creeperdeking/Tropodrone/Latex/diapo_rapport.tex

\documentclass{beamer}

\usepackage{gensymb}
\input{entete_beamer_pdflatex}
\usepackage{listings}
\usepackage[babel=true]{csquotes}
\lstset{language=Python, tabsize=2, breaklines=true, showstringspaces=false}

\useoutertheme{infolines}
\setbeamersize{text margin left=1cm,text margin right=1cm}

\title{Rapport de projet de SI}
\subtitle{Tropodrone}
\author{Gueydan Noé, Manceau Thibaut, Gros Alexis, Porteries Tristan}

\begin{document}

\begin{frame}
  \titlepage
\end{frame}

\begin{frame}
    \frametitle{Sommaire}
    \begin{multicols}{2}
      {
		\setcounter{tocdepth}{1}
        \tableofcontents
      }
    \end{multicols}
\end{frame}

\section{Courte présentation}

\subsection{But du projet}
\begin{frame}{But du projet}
 Créer une structure composée de ballons contenant un gaz plus léger que l’air qui soutient une partie ou la totalité du poids d'un drone.
\end{frame}

\subsection{Objectifs}
\begin{frame}{Objectifs}
 Augmenter l’autonomie, la sécurité et les possibilités d’un drone de petite taille
\end{frame}

\subsection{Contraintes imposées au projet}
\begin{frame}{Contraintes imposées au projet}
  \begin{itemize}
    \item être simple d’utilisation, garder la manœuvrabilité du drone au possible, voler le plus longtemps possible~;
    \item consommer le moins d’énergie possible, ne pas présenter de danger pour le public et économiser le gaz et les matériaux de fabrication~;
    \item le modèle du drone imposé~;
    \item rayon d’action de minimum 15 mètres~;
    \item ballon de type dirigeable.
  \end{itemize}
\end{frame}

\subsection{Contraintes légales supplémentaires}
\begin{frame}{Contraintes légales supplémentaires}
  \begin{itemize}
    \item 1~: Le drone \\
	    catégorie A~: limitations non contraignantes~;
    \item 2~: Le ballon \\
	    catégorie « Léger » \\
	    la ficelle supportant la charge doit casser au dessus de 23 kg.
 \end{itemize}
\end{frame}

\section{Calculs d'élévation}

\subsection{Poussé d'archimède}

\begin{frame}{Définition}
  \enquote{Tout corps plongé dans un fluide au repos, entièrement mouillé par celui-ci ou traversant sa surface libre, subit une force verticale, dirigée de bas en haut et opposée au poids du volume de fluide déplacé ; cette force est appelée poussée d'Archimède.}
  \bigbreak
  \begin{center}
    \boxed{\vv{Pa} = -M_F \times \vv{g}}
  \end{center}
  \begin{itemize}
    \item $\vv{Pa}$~: la poussé d'archimède~;
    \item $M_F$~: la masse du fluide contenue dans le volume déplacé~;
    \item $\vv{g}$~: la valeur du champ de pesanteur.
  \end{itemize}
\end{frame}

\begin{frame}{Application aux gaz}
  Deux forces appliquées sur le ballon~: \\
  \begin{center}
    $\displaystyle{\vv{F_{ballon}} = \vv{P_{ballon}} + \vv{Pa_{ballon}}}$ \\
  \end{center}
  Si $P_{ballon} < Pa_{ballon}$ la force d'élévation est~:
  \begin{center}
    $\displaystyle{F_{ballon} = Pa_{ballon} - P_{ballon}}$ \\
  \end{center}
  Remarque~:\\
  \begin{center}
    $F_{ballon} < Pa_{ballon}$
  \end{center}
\end{frame}

\begin{frame}{Hydrogène et hélium}
	\begin{center}
		\begin{tabular}{|l|c|c|c|}
			\hline
			Gaz & Air & Hydrogène & Hélium \\
			\hline
			Masse Volumique $(kg.m^3)$ & 1.29 & 0.08988 & 0.1785 \\ 
			\hline
			Force d'élévation $(N.m^3)$ & 0 & 10.90 & 11.77 \\
			\hline
		\end{tabular}
	\end{center}
\end{frame}

\subsection{Dilatation des gaz}

\begin{frame}{Loi de Charles}
  \begin{center}
    \boxed{\displaystyle{\frac{V_1}{T_1} = \frac{V_2}{T_2} = f(P, n)}} \\
    $\displaystyle{V_3 = f(P, n) \times T_3}$
  \end{center}
  Avec~:
  \begin{itemize}
    \item $V_q$~: volume du gaz en $m^3$ à la température $T_q$ en K~;
    \item $P$~: pression du gaz en Pa~;
    \item $n$~: quantité de matière en mol~;
    \item $f(P, n)$~: rapport constant entre volume et température.
  \end{itemize}
\end{frame}

\begin{frame}{Application à l'hélium}
  Volume molaire de l'hélium~: $22.414\times 10^{-3} m^3.mol^{-1}$ à $273.25K$.
  \begin{center}
    $\displaystyle{f(P, n) = \frac{22.414\times 10^{-3}}{273.25} = 8.2\times 10^{-5} m^3.mol^{-1}.K^{-1}}$
  \end{center}
  Pour $T_{200} = 200 \degree C = 473.25 K$~:
  \begin{center}
    $\displaystyle{V_{T_{200}} = 8.2\times 10^{-5} * 473.25 = 38.811 \times 10^{-3}} m^3.mol^{-1}$
  \end{center}
  Augmentation du volume de $1.59$.
\end{frame}

\begin{frame}{Résultat de la poussé d'archimède}
  \begin{center}
    $\displaystyle{F_{T_0} = Pa_{air} - P_{helium} = 10.90 N}$
    \bigbreak
    $\displaystyle{F_{T_{200}} = Pa_{air} - \frac{P_{helium}}{1.59} = 11.57 N}$ \\
  \end{center}
  Les resultats sont négligables. $F < Pa_{air}$
\end{frame}

\section{Structure}

\subsection{Piloter le drone}

\begin{frame}
  La structure~: piloter le drone.
  Les contraintes~:
  \begin{itemize}
    \item mobilité~;
    \item rigidité~;
    \item légerté~;
    \item légalité.
  \end{itemize}
\end{frame}

\begin{frame}{Les solutions techniques}
  Légerté et rigidité~: fibres de carbonne Répartition des matériaux et expériences.
  \begin{center}
    
  \end{center}
\end{frame}

\begin{frame}{Mobilité}
  Forme triangulaire des ballons, centre de gravité, le même que celui du drone, quantité d'hélium. \\
  Structure gyroscopique.
  \begin{center}
    
  \end{center}
\end{frame}

\subsection{Attaches et modélisation}

\begin{frame}
  \begin{center}
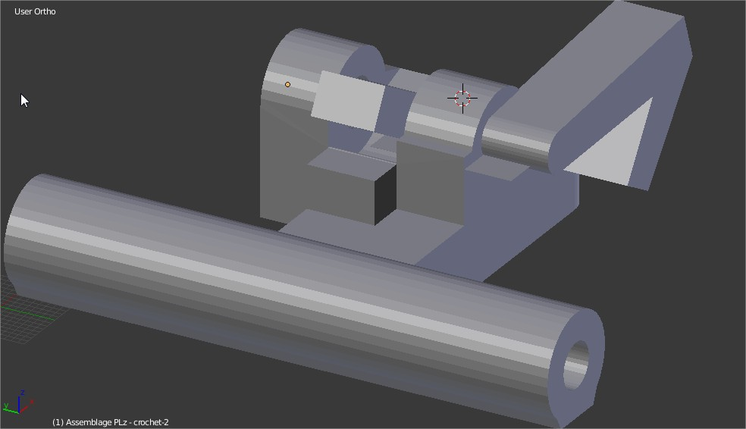
[picture p17: Images/fixation.jpg]
    
  \end{center}
  \captionof{figure}{Fixation triangle-premier cercle.}
\end{frame}

\section{Ballon}

\subsection{Contenance}

\begin{frame}
  Volume d'helium nécessaire~: $0.75 m^3$
  
  Volume des ballons~: $0.25 m^3$
\end{frame}

\subsection{Forme}

\begin{frame}
  Les ballon sont formés d'un parallèlépipède de longueur 1m avec deux pyramides d'angle $60\degree$. Orientation de $45\degree$ \\
  \begin{center}
    
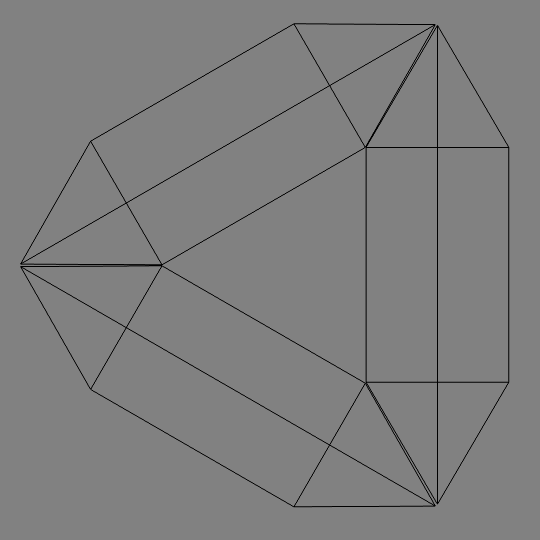
[picture p18: Images/ballon3.png]
    
  \end{center}
\end{frame}

\begin{frame}{Calcul des dimensions}
  Volume ballon~:
  \begin{center}
    \boxed{\displaystyle{V = 2(\sqrt{2b^2} \times \tan \frac{\pi}{3} \times \frac{1}{3} \times b^2) + b^2}} \\
    $\displaystyle{V = 2(\frac{\sqrt{6}}{3} \times b^3) + b^2 }$ \\
    $\displaystyle{b^3 \frac{2\sqrt{6}}{3} + b^2 - 0.25 = 0}$
  \end{center}
  Où $b$ est la largeur du parallèlépipède. \\
  Polynome du troisième degrée, résolution par bissection ou dichotomie.
\end{frame}

\begin{frame}[fragile]{Résolution par bissection}
  \begin{lstlisting}[frame=single]
etape = 1
largeur = 1
vol = volume(largeur)
cible = 0.25
epsilon = 1e-4
while abs(vol - cible) > epsilon:
	if vol < cible:
		largeur += etape
	else:
		largeur -= etape
	etape /= 2
	vol = volume(largeur)

print("volume = %f, diametre = %f" % (vol, largeur))
  \end{lstlisting}
\end{frame}

\subsection{Patron du ballon}

\begin{frame}
  \begin{center}
    
  \end{center}
\end{frame}

\subsection{Enveloppe}

\begin{frame}
  \begin{multicols}{2}
    \begin{itemize}
      \item Latex~:
      \begin{itemize}
        \item facile à trouver dans le commerce,
        \item seulement en forme sphèrique,
        \item peu étanche~;
      \end{itemize}
      \item Chloroprène~:
      \begin{itemize}
        \item introuvable dans le commerce~;
      \end{itemize}
      \item Butyle~:
      \begin{itemize}
        \item introuvable dans le commerce~;
      \end{itemize}
      \item Hypalon~:
      \begin{itemize}
        \item introuvable dans le commerce,
        \item fragile aux ultraviolets.
      \end{itemize}
    \end{itemize}
    \newpage
    \begin{itemize}
      \item Mylar (polyéthylène téréphtalate, PET)~:
      \begin{itemize}
        \item facile à trouver dans le commerce,
        \item resistant à la traction,
        \item peu être assembler,
        \item raide,
        \item fragile au cisaillement et à la perforation.
      \end{itemize}
    \end{itemize}
  \end{multicols}
\end{frame}

\subsection{Collage}

\begin{frame}
  \begin{multicols}{2}
    \begin{itemize}
      \item Néoprène(Polychloroprène)
      \begin{itemize}
        \item étanche,
        \item élastique,
        \item adhèrent,
        \item difficile à appliquer~;
      \end{itemize}
      \item 406 (cyanoacrylate d'ethyle) et 770 (primaire)
      \begin{itemize}
        \item adhèrent,
        \item rigide,
        \item peu résistant à l'eau,
        \item facile à appliquer~;
      \end{itemize}
      \item 401 (cyanoacrylate) et 770 (primaire)
      \begin{itemize}
        \item adhèrent,
        \item rigide,
        \item peu résistant à l'eau,
        \item facile à appliquer.
      \end{itemize}
    \end{itemize}

    \newpage

    \begin{itemize}
      \item 330 et activateur
      \begin{itemize}
        \item peu adhèrent,
        \item élastique~;
      \end{itemize}
      \item Polyester
      \begin{itemize}
        \item peu adhèrent~;
      \end{itemize}
      \item Polyuréthane
      \begin{itemize}
        \item peu adhèrent~;
      \end{itemize}
      \item Acétone
      \begin{itemize}
        \item peu adhèrent~;
      \end{itemize}
      \item Vinylique
      \begin{itemize}
        \item peu adhèrent.
      \end{itemize}
    \end{itemize}
    %\begin{center}
    %  \includegraphics[width=5cm]{../Images/colle2.jpg}
    %\end{center}
    %\captionof{figure}{A gauche la colle 406 et à droite la colle acétone.}
  \end{multicols}
\end{frame}

\subsection{Performance d'un collage}

\begin{frame}{Contrainte d'une colle}
  Différents types de contraintes sur une colle:
  \begin{center}
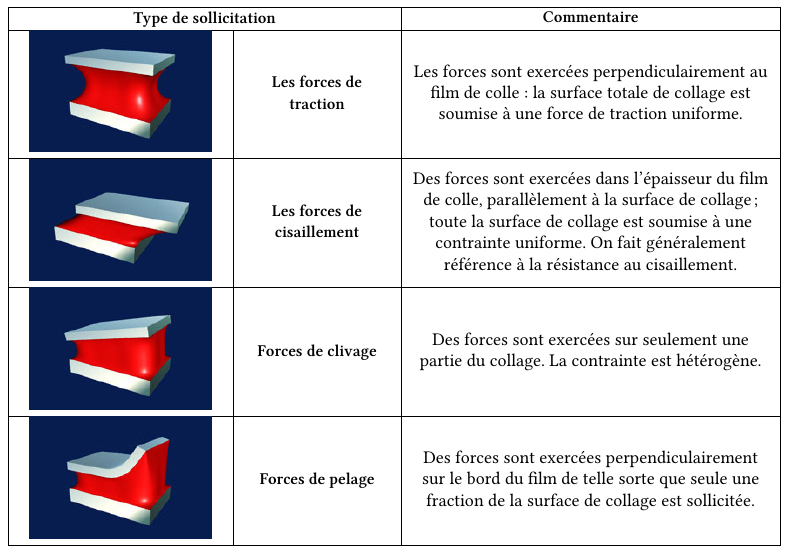
[picture p19: Images/colle_contraintes.png]
    
  \end{center}
\end{frame}

\begin{frame}
  Collage du ballon extérieur: contrainte de pellage.
  \begin{center}
    
    
  \end{center}
\end{frame}

\begin{frame}{Tests 401 (cyanoacrylate)}
  \begin{center}
    \begin{tabular}{|c|c|}
      \hline
      Pelage & Cisaillement \\
      \hline
      $0.45 N.cm^{-2}$ & $12.1 N.cm^{-2}$ \\
      \hline
    \end{tabular}
  \end{center}
  \begin{center}
    
    
  \end{center}
\end{frame}

\section{Drone}

\subsection{Modèle}

\begin{frame}
  \begin{multicols}{2}
    Drone XCSOURCE~: \\
    \begin{itemize}
      \item 290 mm diagonale~;
      \item 190 mm longueur~;
      \item 70 mm hauteur~;
      \item moteur EMAX MT2204 2300KV Brushless Motor~;
      \item Accu Lipo Gens Ace 2200Mah 11.1V 25C 3S~;
      \item 450 g.
    \end{itemize}
    \newpage
    \begin{center}
      
    \end{center}
    \captionof{figure}{Drone XCSOURCE.}
  \end{multicols}
\end{frame}

\subsection{Capacité et poids}

\section{Aérodynamisme}

\subsection{Équation de traînée}
\begin{frame}{Équation de traînée}
 But : que le drone soit le moins sensible à l'air possible \\
 Force de traînée matérialisée par l'équation \\
 \begin{center}
  \boxed{\displaystyle{\frac12 \times \rho \times S \times Cx \times V^2}}
 \end{center}
 Avec~:
 \begin{itemize}
  \item $\rho$ la masse volumique du fluide dans lequel a lieu le déplacement en $kg.m^{-3}$~;
  \item S la surface~;
  \item Cx le coefficient de traînée~;
  \item V la vitesse relative du mobile par rapport au fluide en $m.s^{-1}$.
 \end{itemize} 
\end{frame}

\subsection{Calcul de Cx}
\begin{frame}{Nombre de Reynolds}
 \begin{center}
  \boxed{\displaystyle{Re = \frac{VL}{\nu}}}
 \end{center}
 Avec~: \\
 \begin{itemize}
  \item V vitesse du fluide en $m.s^{-1}$~;
  \item L diamètre en m~;
  \item $\nu$ Viscosité cinématique en $m^2.s^{-1}$ ($\nu = 15.6 \times 10^6$ pour l'air).
 \end{itemize} 
\end{frame}

\begin{frame}{Calcul de Cx pour la forme retenue}
 Forme la plus proche : sphère \\
 Dépend du type d'écoulement : le nombre de reynolds \\
 \begin{center}
  $\begin{array}{>{\displaystyle}l>{\displaystyle}l>{\displaystyle}l}
   Re < 1 & Cx = & \frac{24}{Re} \medbreak \\
   1 < Re < 10^3 & Cx = & \frac{18.5}{Re^{0.6}} \medbreak \\
   10^3 < Re < 5.10^5 & Cx = & 0.44
  \end{array}$
 \end{center}
\end{frame}

\section{Taches à faire}
\begin{frame}
  \begin{itemize}
    \item terminer les pièces du ballon~;
    \item assembler la structure~;
    \item assembler les ballons~;
    \item tester et calculer l'aérodynamisme~;
    \item calibrer le drone~;
    \item acheter l'helium.
  \end{itemize}
\end{frame}

\end{document}
