creeperdeking/Tropodrone/Latex/diapo_general.tex

\documentclass{beamer}

\usepackage{gensymb}
\input{entete_beamer_pdflatex}
\usepackage{listings}
\usepackage{transparent}
\usepackage[babel=true]{csquotes}
\lstset{language=Python, tabsize=2, breaklines=true, showstringspaces=false}

\definecolor{RedT}{rgb}{1, .7, .7}
\definecolor{GreenT}{rgb}{.7, 1, .7}
\definecolor{OrangeT}{rgb}{1, 1, .7}

\useoutertheme{infolines}
\setbeamersize{text margin left=1cm,text margin right=1cm}

\title{Rapport de projet de SI}
\subtitle{Tropodrone}
\author{Gueydan Noé, Manceau Thibaut, Gros Alexis, Porteries Tristan}

\usebackgroundtemplate%
{%
    {\transparent{0.2}}%
}

\begin{document}

\begin{frame}
  \titlepage
\end{frame}

\begin{frame}
    \frametitle{Sommaire}
    \begin{multicols}{2}
      {
		\setcounter{tocdepth}{1}
        \tableofcontents
      }
    \end{multicols}
\end{frame}
