creeperdeking/Tropodrone/Images/ballon2.jpg

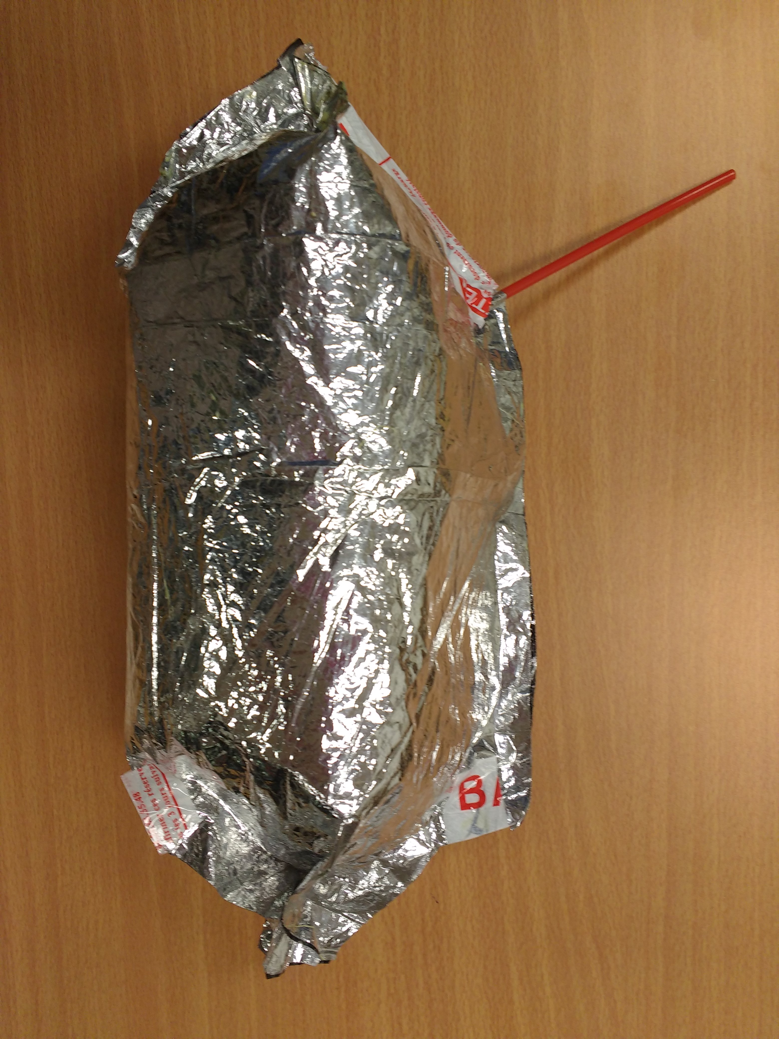
Images/ballon2.jpg
