creeperdeking/Tropodrone/Images/ballon3.jpg

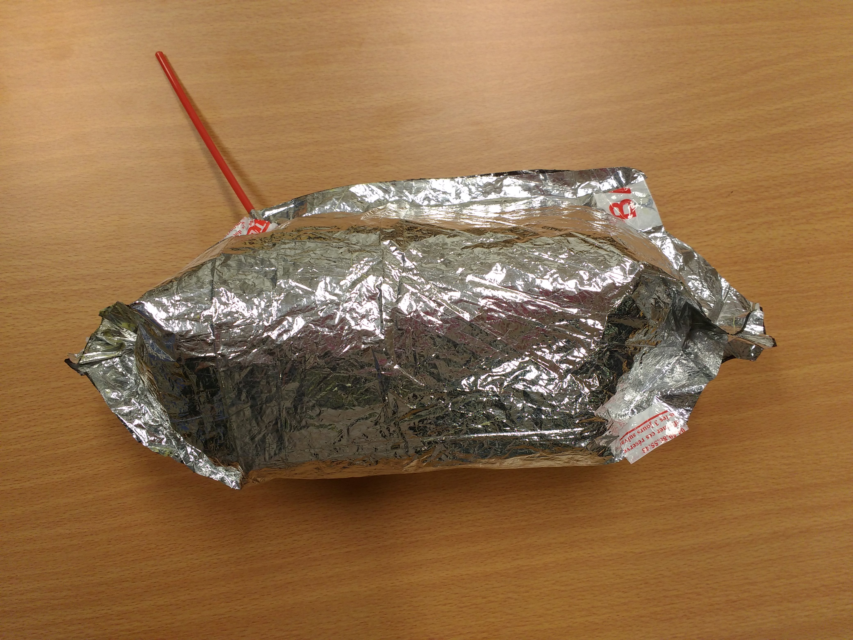
Images/ballon3.jpg
