creeperdeking/Tropodrone/Images/colle.JPG

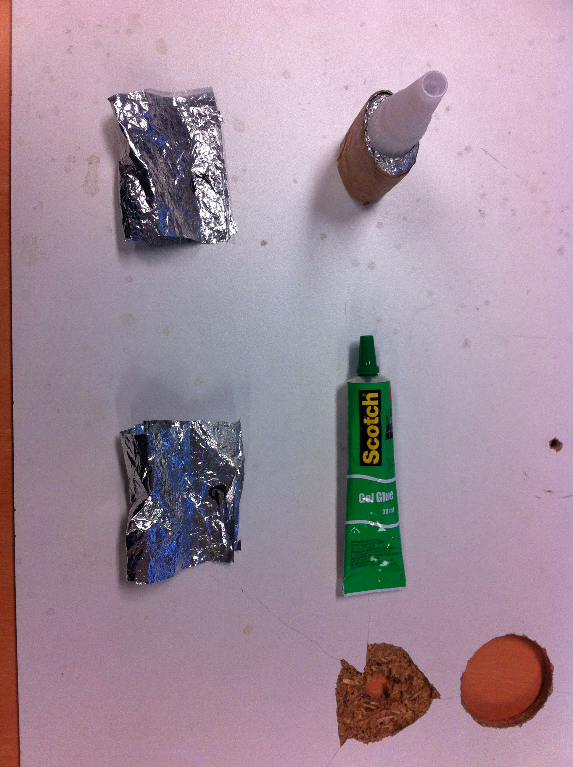
Images/colle.JPG
