creeperdeking/Tropodrone/Images/colle_cyano.JPG

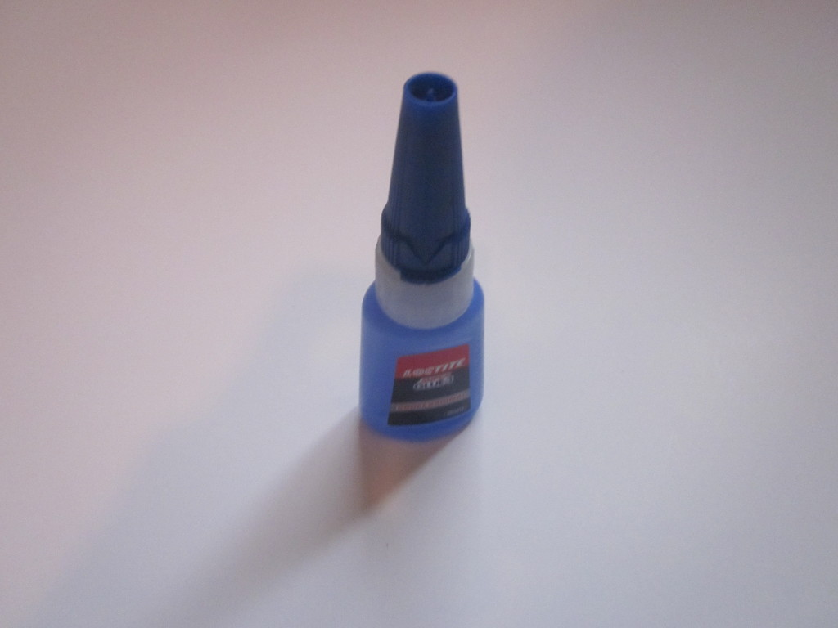
Images/colle_cyano.JPG
