creeperdeking/Tropodrone/Images/IMG_20170321_155133.jpg

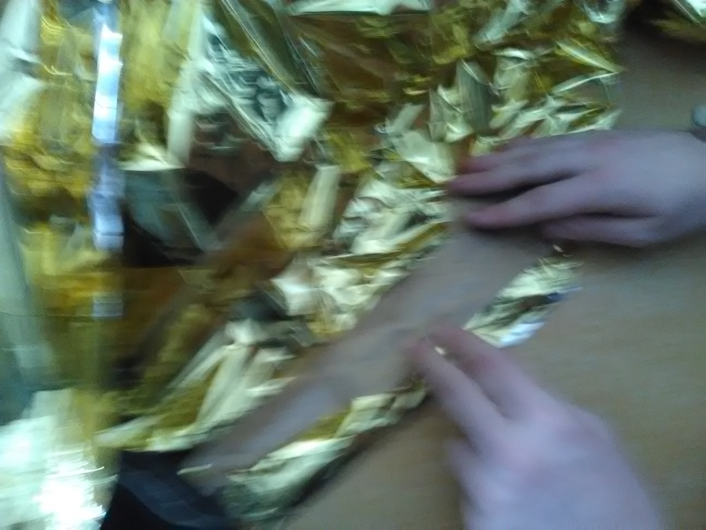
Images/IMG_20170321_155133.jpg
