creeperdeking/Tropodrone/Images/IMG_20170321_155136.jpg

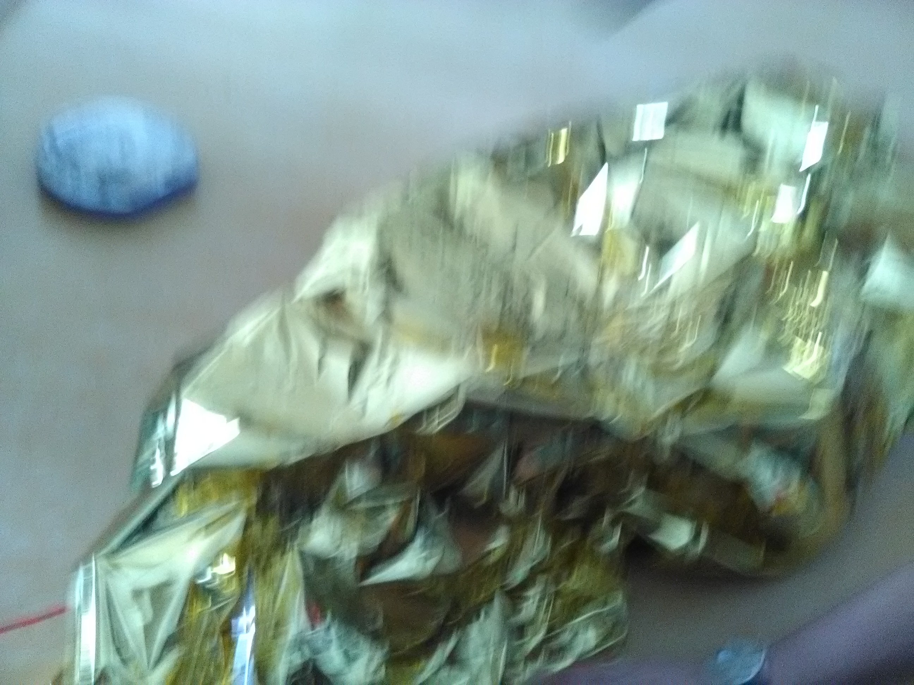
Images/IMG_20170321_155136.jpg
