creeperdeking/Tropodrone/Images/IMG_20170321_155141.jpg

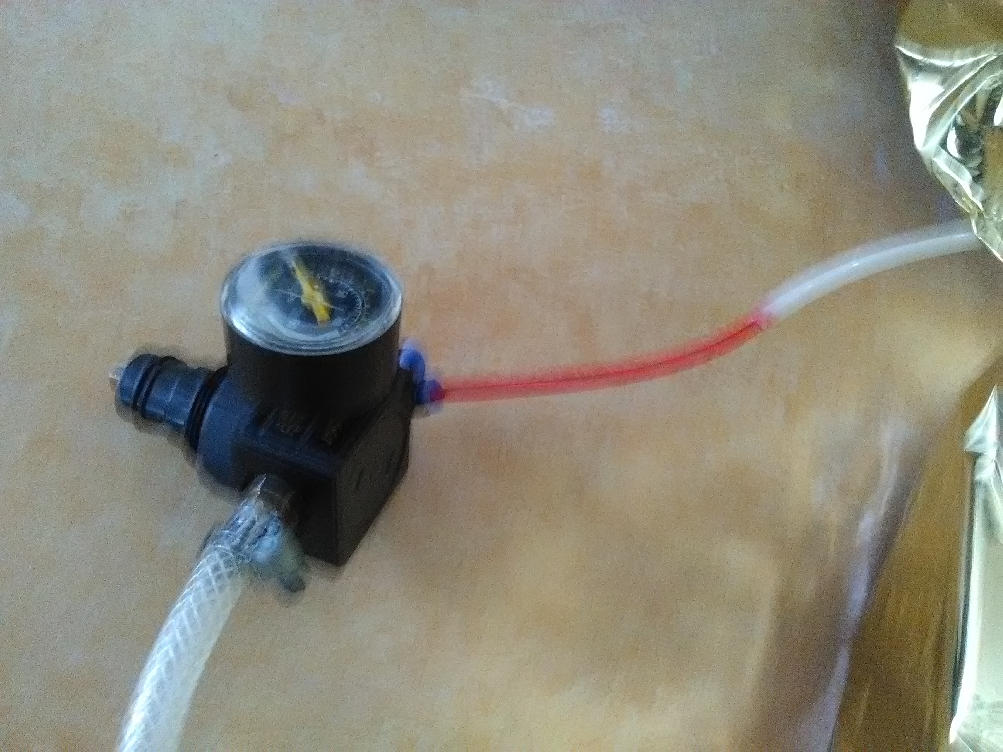
Images/IMG_20170321_155141.jpg
