creeperdeking/Tropodrone/Images/IMG_20170321_155143.jpg

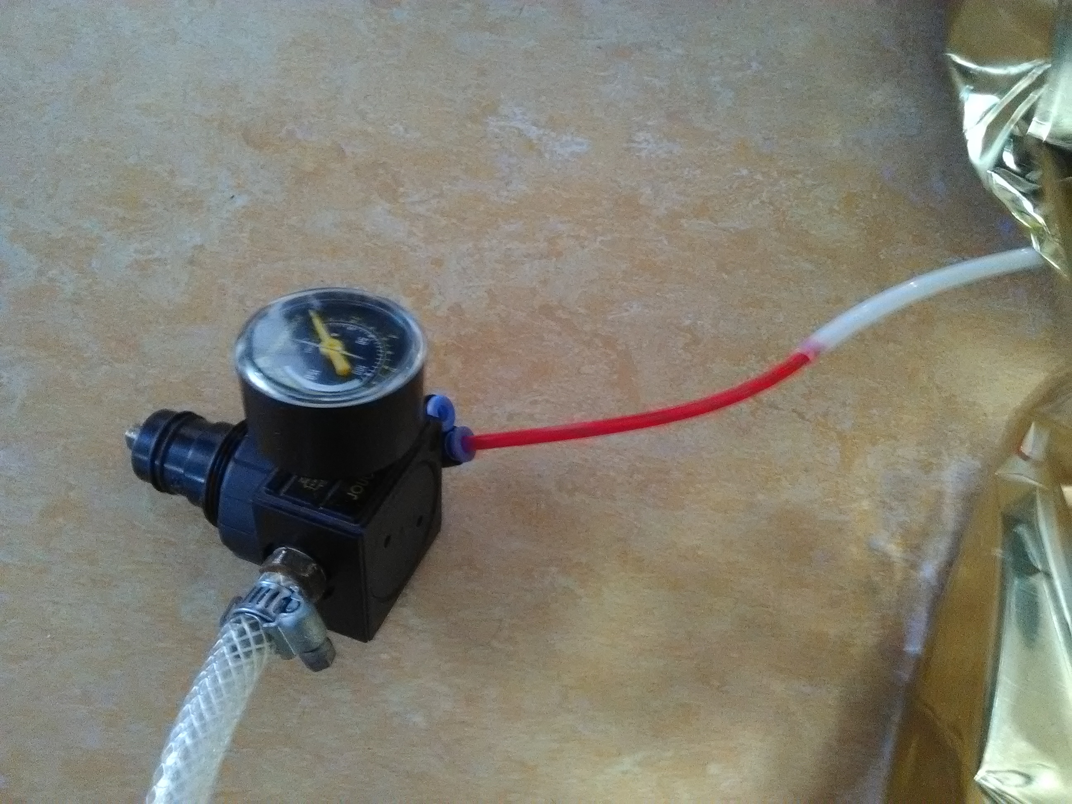
Images/IMG_20170321_155143.jpg
