creeperdeking/Tropodrone/Images/IMG_20170321_160333.jpg

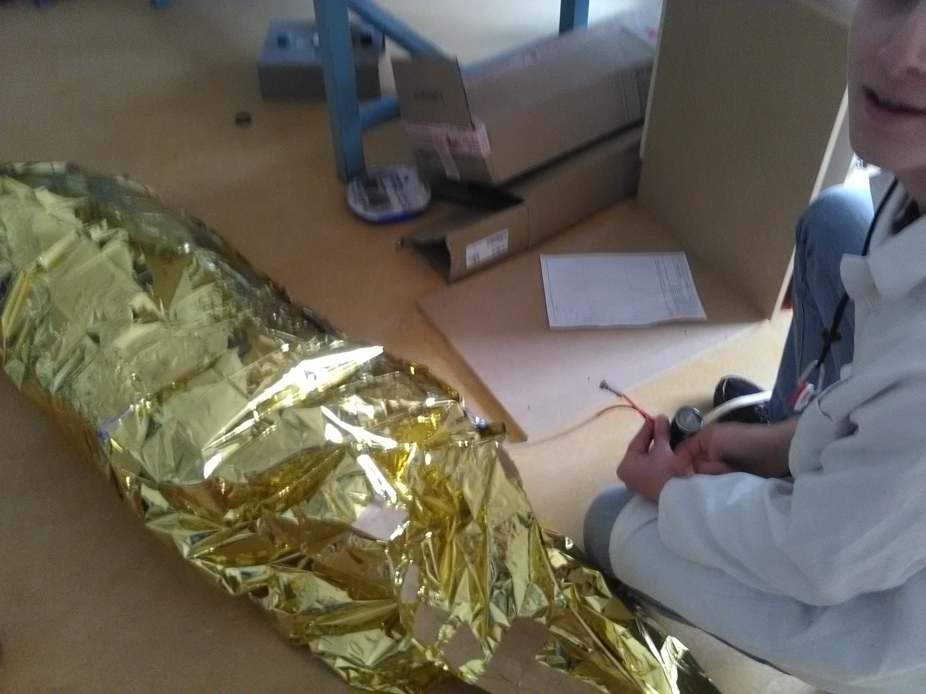
Images/IMG_20170321_160333.jpg
