creeperdeking/Tropodrone/Images/IMG_20170321_160751.jpg

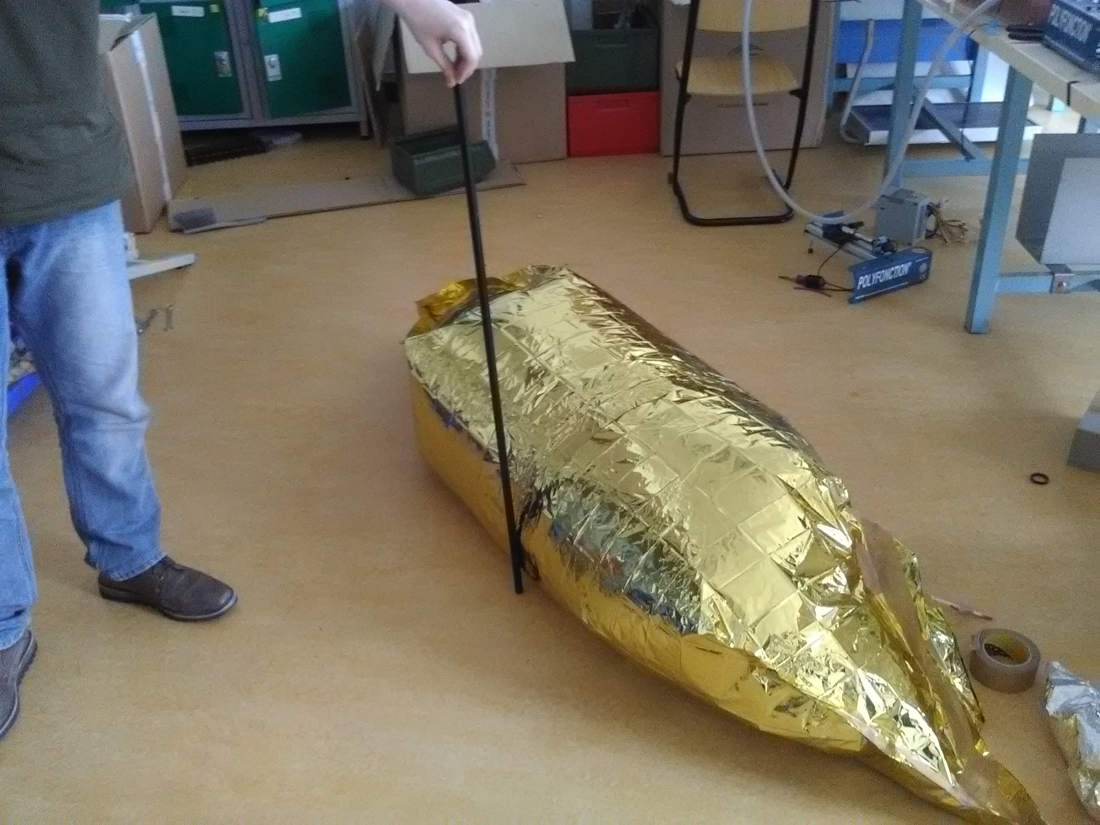
Images/IMG_20170321_160751.jpg
