creeperdeking/Tropodrone/Images/IMG_20170321_162557.jpg

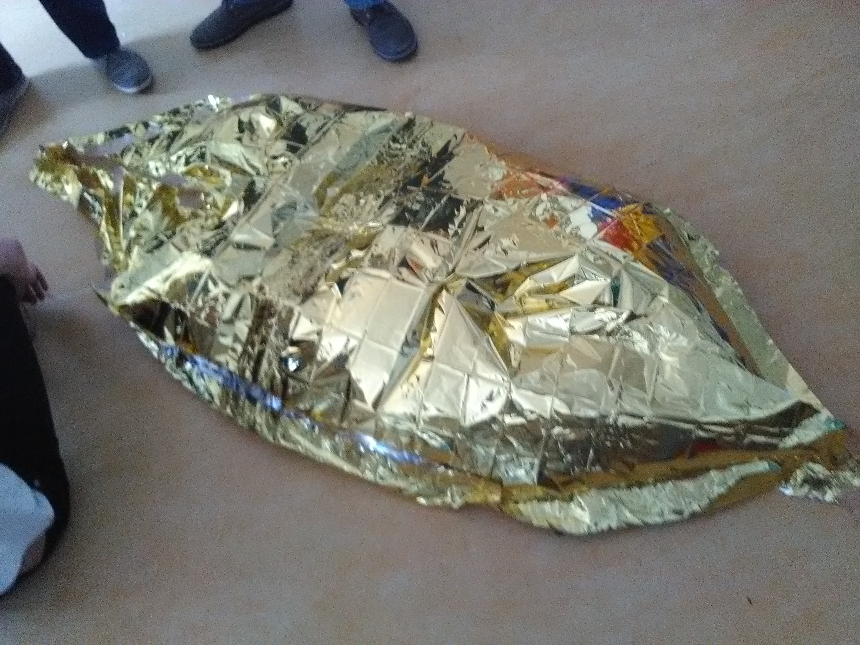
Images/IMG_20170321_162557.jpg
