creeperdeking/Tropodrone/Images/IMG_20170321_162559.jpg

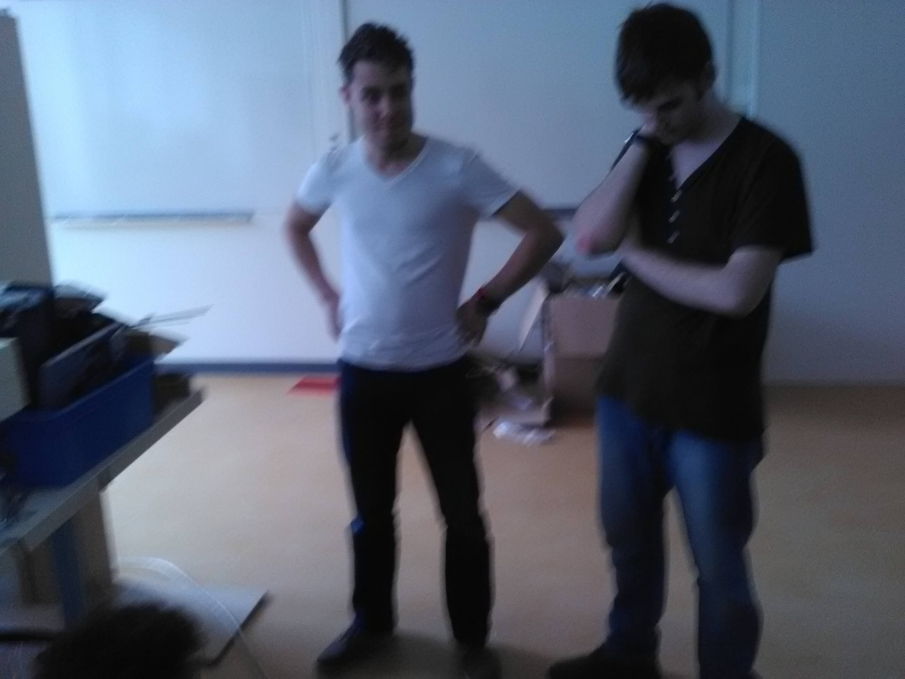
Images/IMG_20170321_162559.jpg
