creeperdeking/Tropodrone/Images/IMG_20170321_162600.jpg

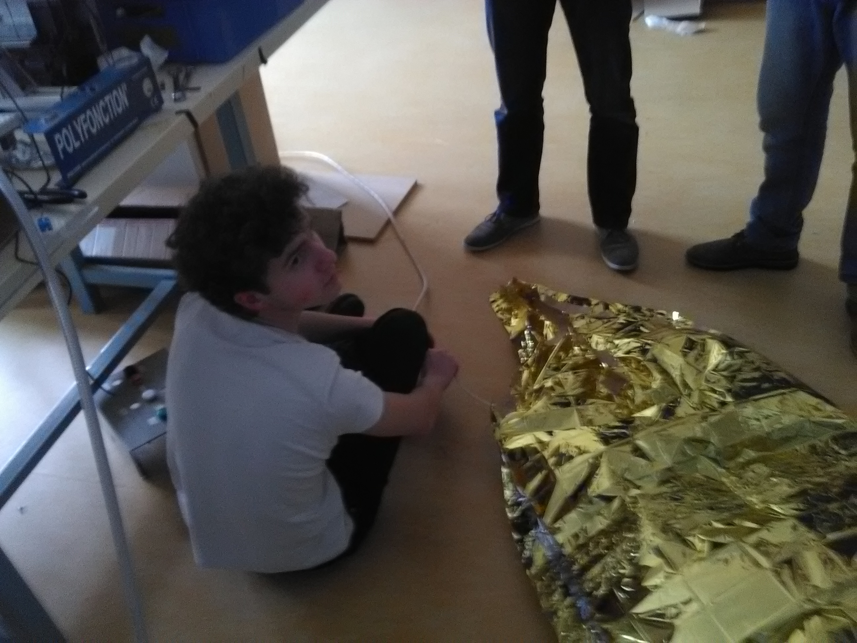
Images/IMG_20170321_162600.jpg
