creeperdeking/Tropodrone/Images/Photos/IMG_20161213_135336.jpg

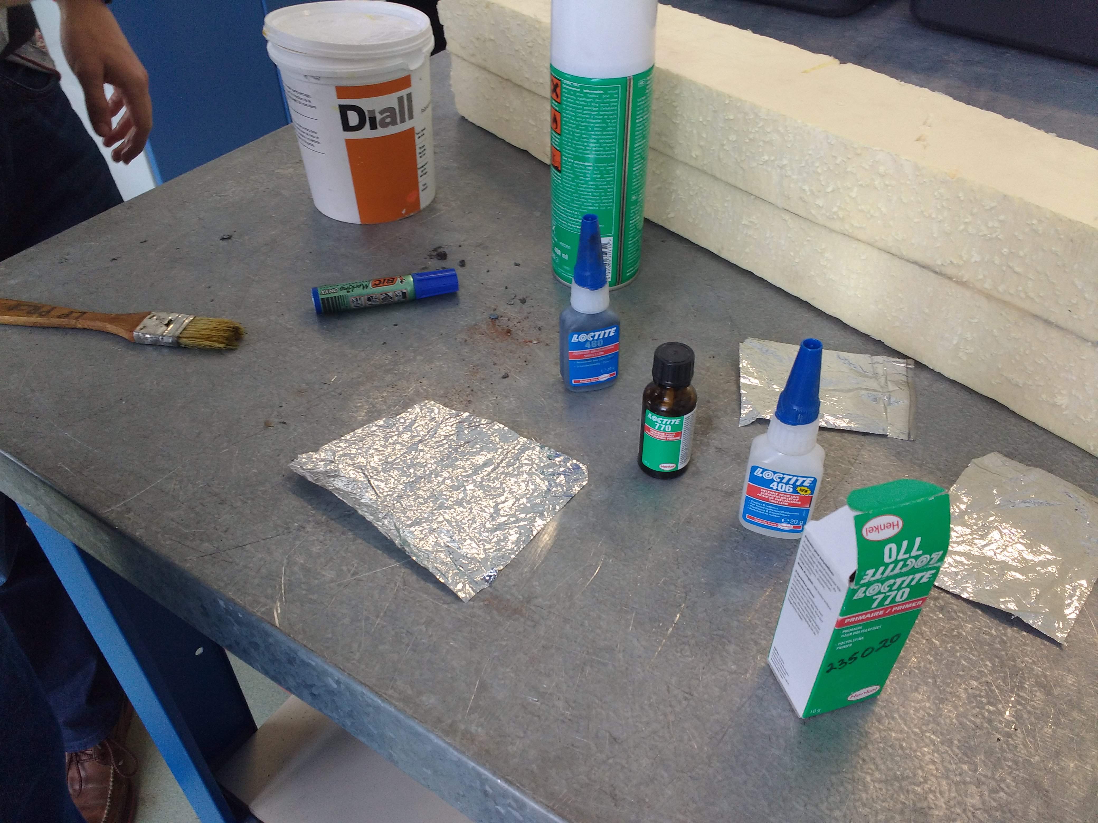
Images/Photos/IMG_20161213_135336.jpg
