creeperdeking/Tropodrone/Images/Photos/IMG_20161213_160055.jpg

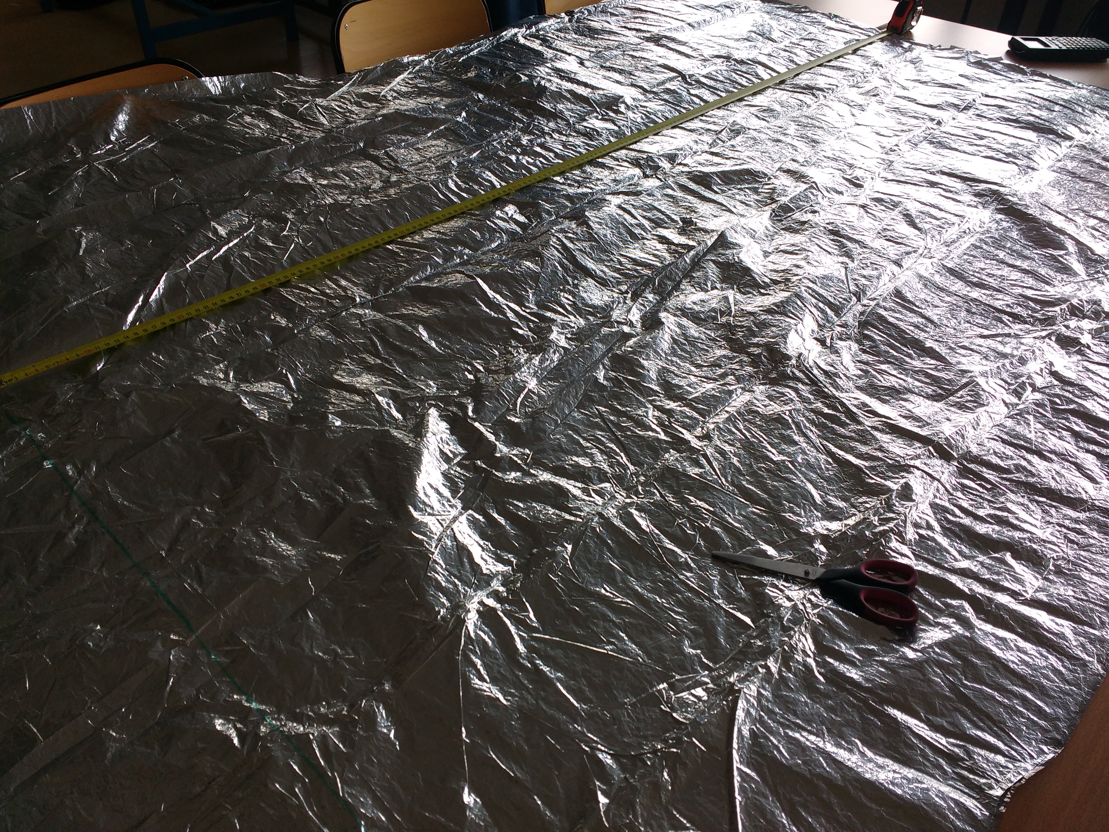
Images/Photos/IMG_20161213_160055.jpg
