creeperdeking/Tropodrone/Images/Photos/IMG_20170110_164948.jpg

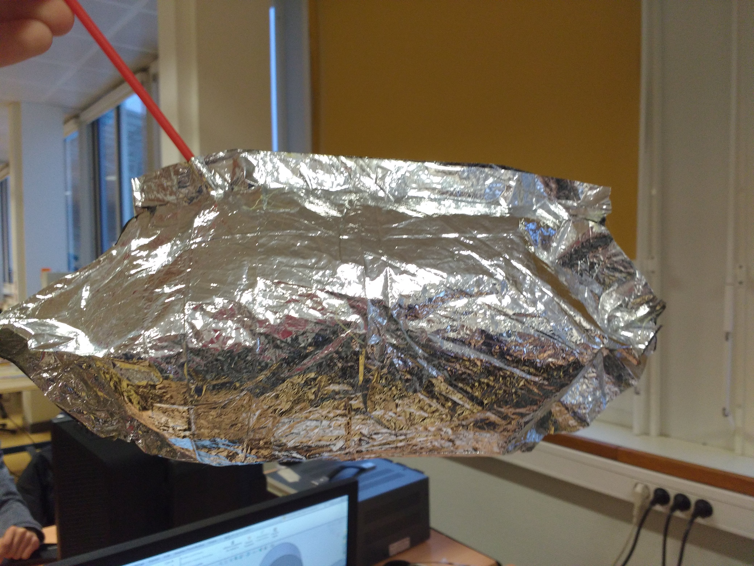
Images/Photos/IMG_20170110_164948.jpg
