creeperdeking/Tropodrone/Images/Photos/IMG_20170113_115555.jpg

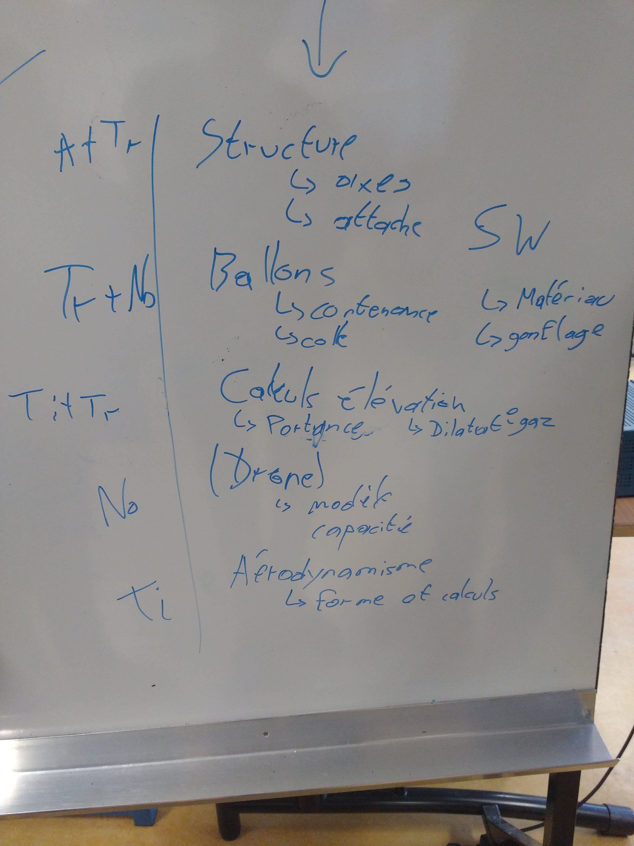
Images/Photos/IMG_20170113_115555.jpg
