creeperdeking/Tropodrone/Images/piece.png

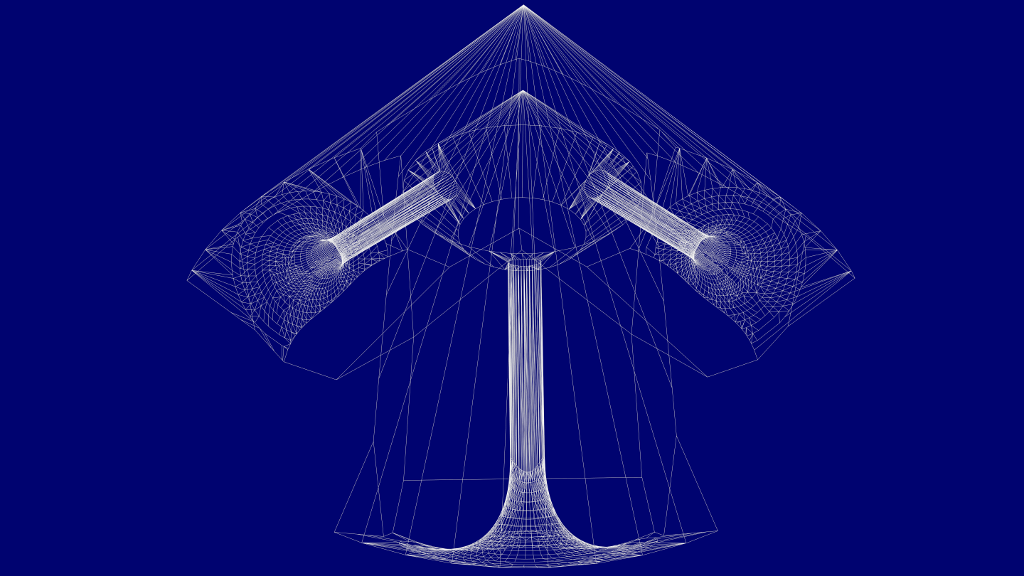
Images/piece.png
