creeperdeking/Tropodrone/Images/piece_vue_1.png

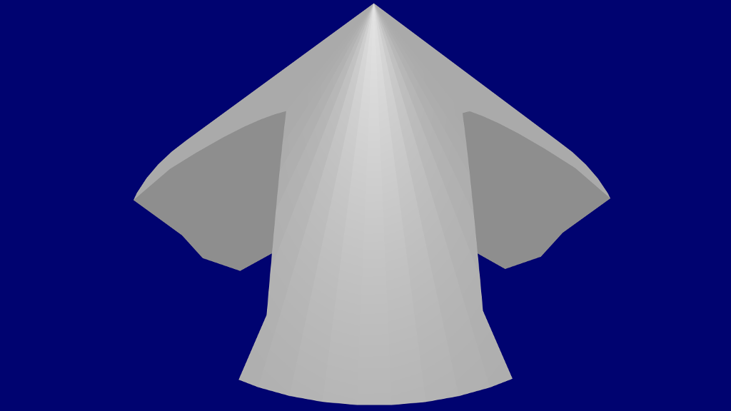
Images/piece_vue_1.png
