creeperdeking/Tropodrone/Images/piece_vue_2.png

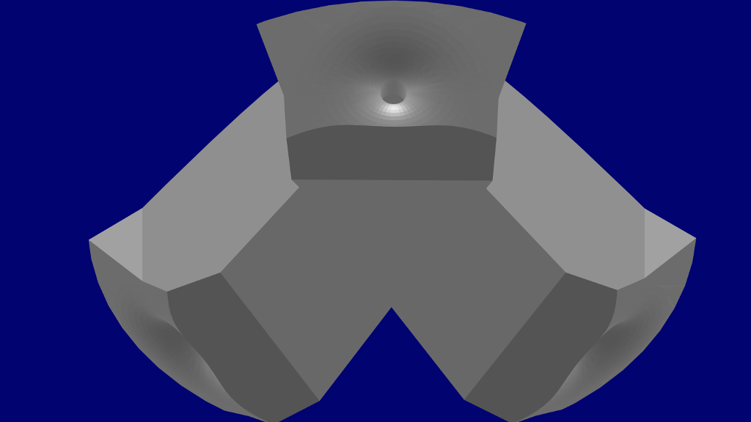
Images/piece_vue_2.png
