creeperdeking/Tropodrone/Images/piece_vue_3.png

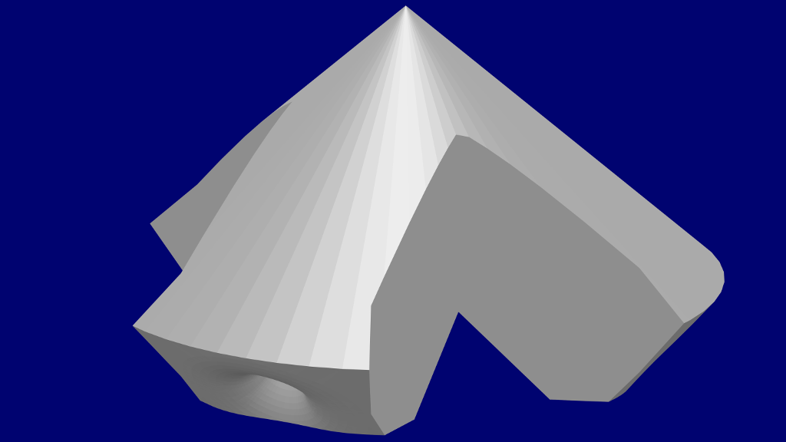
Images/piece_vue_3.png
