creeperdeking/Tropodrone/Images/surface.PNG

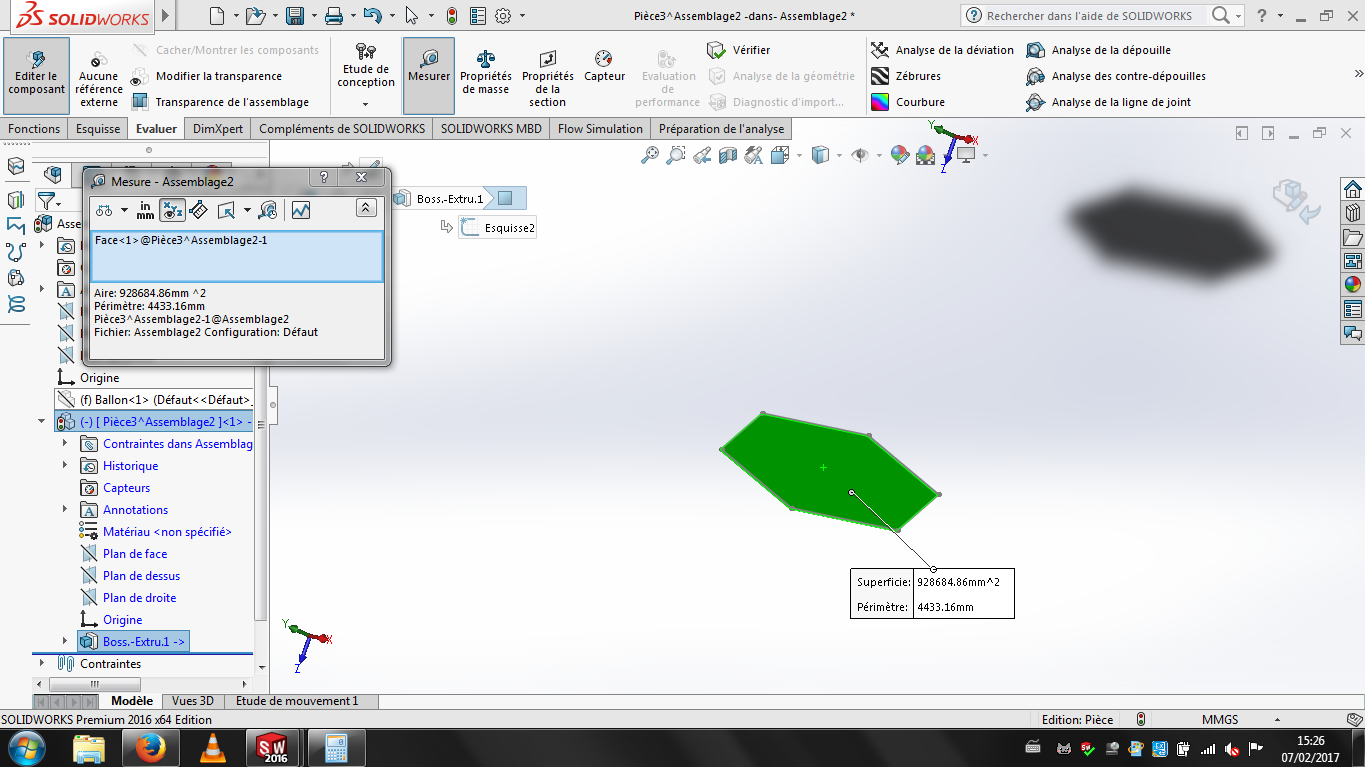
Images/surface.PNG
