creeperdeking/Tropodrone/TS1_GR2/SW/ancienneVersion/Assemblage1 - Ballon-1.STL

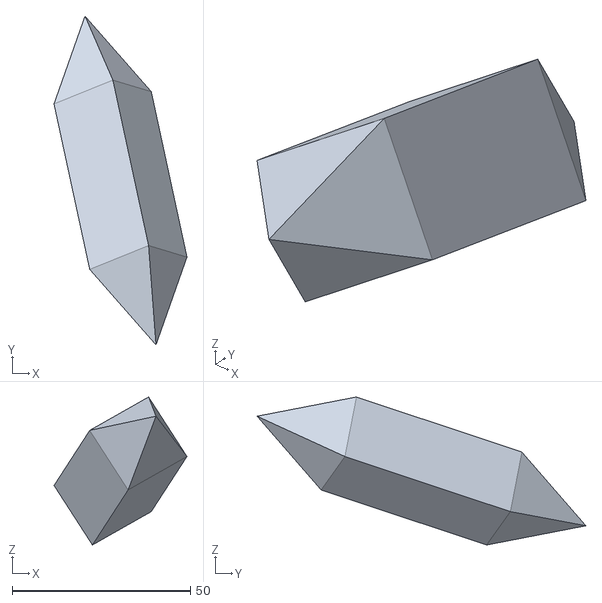
[picture p59: CAD file, 2017-04-11]
TS1_GR2/SW/ancienneVersion/Assemblage1 - Ballon-1.STL
37.4 x 92.4 x 41.6
