creeperdeking/Tropodrone/TS1_GR2/SW/nouvelleVersion/AssemblageNEW.SLDASM

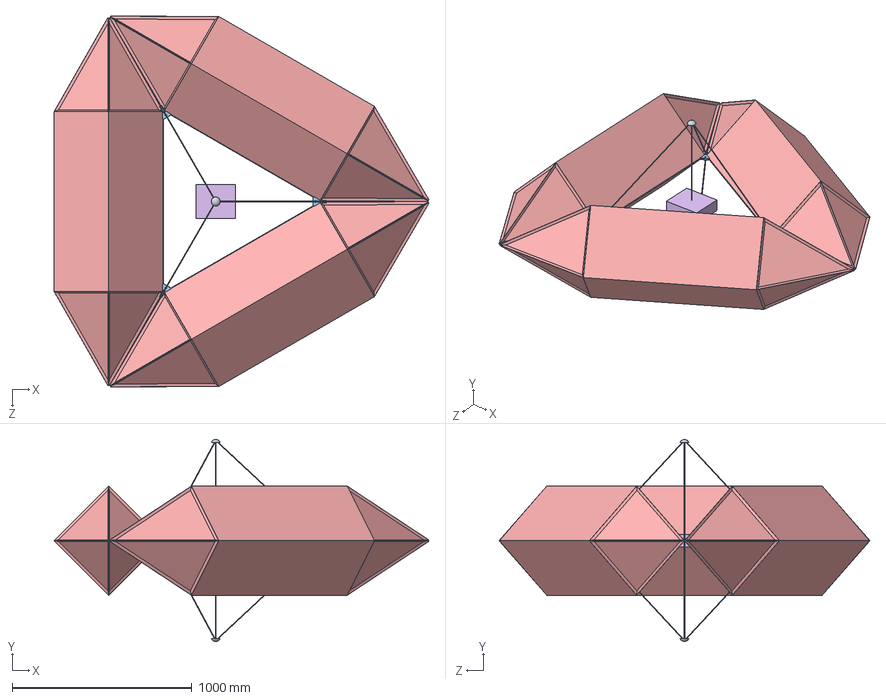
[picture p60: CAD file, 2017-04-11]
TS1_GR2/SW/nouvelleVersion/AssemblageNEW.SLDASM
2085.8 x 1124.0 x 2063.9 mm
Bout x 2
tigeCarboneCreux4mm x 6
pièceTriangle x 3
tigeCarboneCreux6mm x 3
BALLON x 3
Drone
Corde
