creeperdeking/Tropodrone/TS1_GR2/SW/ancienneVersion/Assemblage1 - Ballon-2.STL

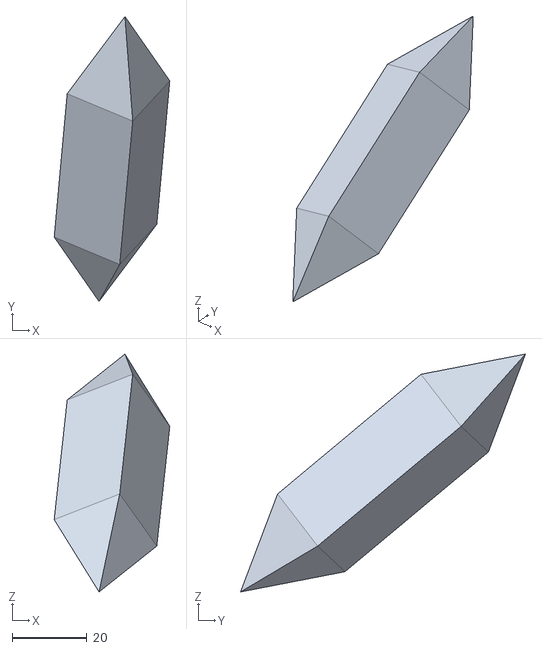
[picture p61: CAD file, 2017-04-11]
TS1_GR2/SW/ancienneVersion/Assemblage1 - Ballon-2.STL
30.9 x 76.1 x 63.5
