creeperdeking/Tropodrone/TS1_GR2/SW/nouvelleVersion/Pièce triangle liaison ballon cercles/Assemblage2.SLDASM

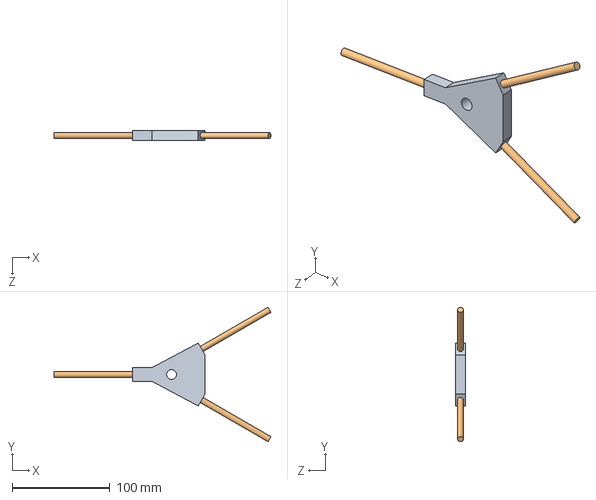
[picture p62: CAD file, 2017-01-10]
TS1_GR2/SW/nouvelleVersion/Pièce triangle liaison ballon cercles/Assemblage2.SLDASM
221.6 x 137.3 x 10.0 mm
pièceTriangle
axesBallon x 3
