creeperdeking/Tropodrone/TS1_GR2/SW/ancienneVersion/Assemblage1 - supportTEMP-1.STL

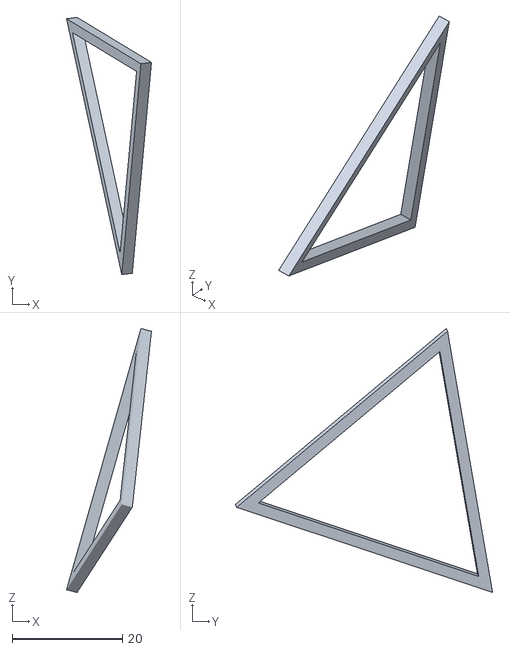
[picture p63: CAD file, 2017-04-11]
TS1_GR2/SW/ancienneVersion/Assemblage1 - supportTEMP-1.STL
15.4 x 46.7 x 47.9
