creeperdeking/Tropodrone/TS1_GR2/SW/nouvelleVersion/Catastrophe.SLDASM

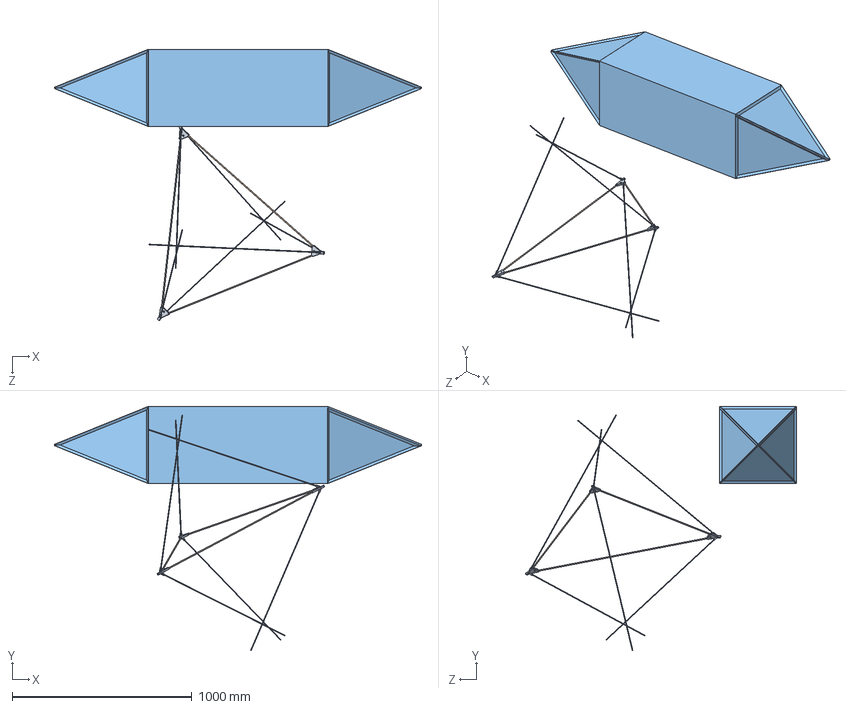
[picture p64: CAD file, 2017-04-11]
TS1_GR2/SW/nouvelleVersion/Catastrophe.SLDASM
2044.4 x 1360.1 x 1511.8 mm
pièceTriangle x 3
tigeCarboneCreux6mm x 3
BALLON
tigeCarboneCreux4mm x 6
