creeperdeking/Tropodrone/TS1_GR2/SW/ancienneVersion/Assemblage1.SLDASM

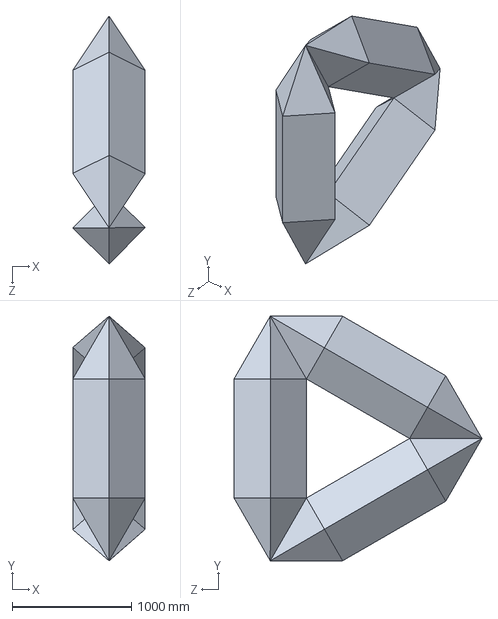
[picture p65: CAD file, 2017-04-11]
TS1_GR2/SW/ancienneVersion/Assemblage1.SLDASM
608.2 x 2053.6 x 2082.6 mm
Ballon x 3
