creeperdeking/Tropodrone/TS1_GR2/SW/ancienneVersion/Assemblage1 - Ballon-3.STL

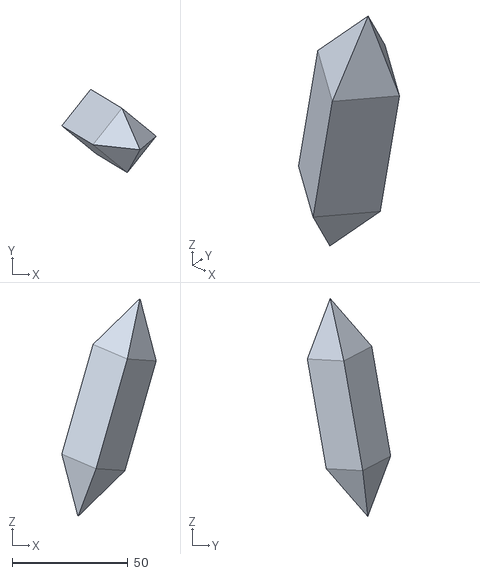
[picture p66: CAD file, 2017-04-11]
TS1_GR2/SW/ancienneVersion/Assemblage1 - Ballon-3.STL
40.9 x 36.1 x 94.3
