creeperdeking/Tropodrone/TS1_GR2/SW/ancienneVersion/Assemblage1IGS.SLDASM

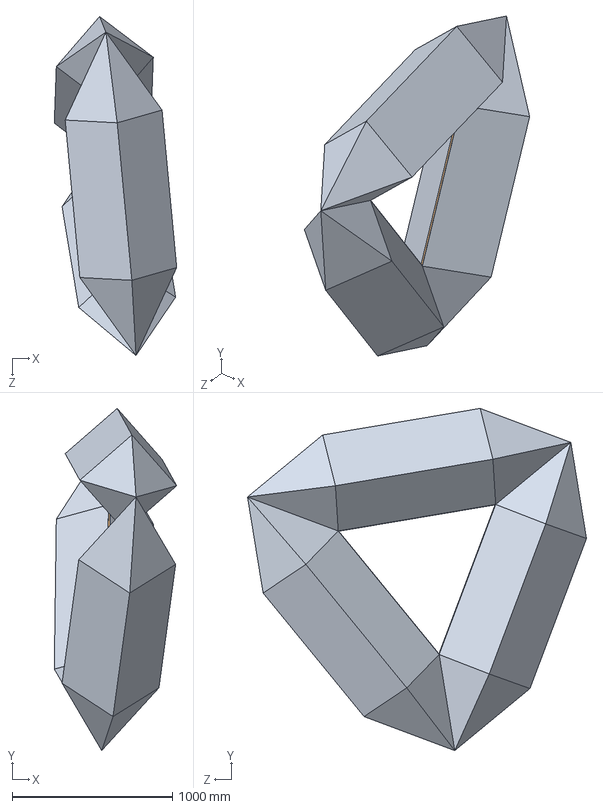
[picture p67: CAD file, 2017-04-11]
TS1_GR2/SW/ancienneVersion/Assemblage1IGS.SLDASM
763.4 x 2133.7 x 2113.9 mm
Ballon_2 x 3
supportTEMP_2
