creeperdeking/Tropodrone/TS1_GR2/SW/ancienneVersion/Pièce attache drone cercle/3mm.SLDPRT

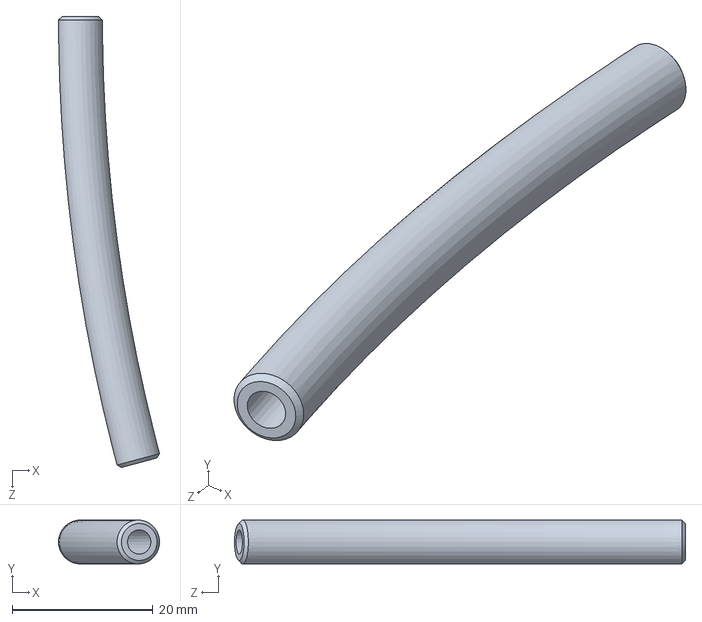
[picture p68: CAD file, 2017-01-10]
TS1_GR2/SW/ancienneVersion/Pièce attache drone cercle/3mm.SLDPRT
14.4 x 6.25 x 64.1 mm
