creeperdeking/Tropodrone/TS1_GR2/SW/ancienneVersion/Pièce triangle liaison ballon cercles/pièceTriangle.SLDPRT

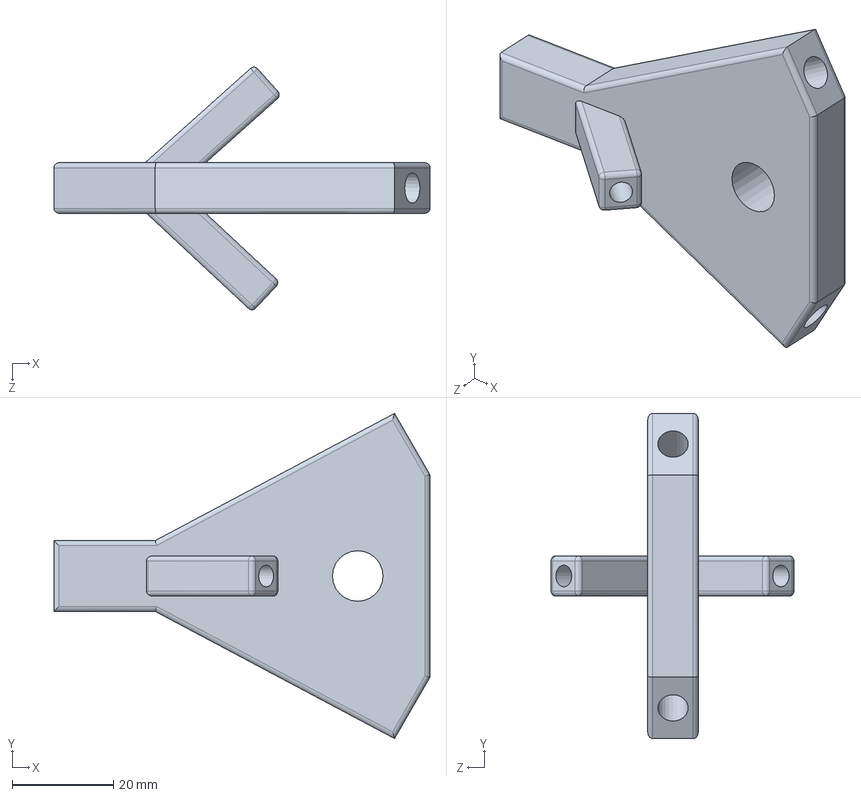
[picture p69: CAD file, 2017-04-11]
TS1_GR2/SW/ancienneVersion/Pièce triangle liaison ballon cercles/pièceTriangle.SLDPRT
74.3 x 64.2 x 48.0 mm
