creeperdeking/Tropodrone/TS1_GR2/SW/nouvelleVersion/Pièce attache drone cercle/5mm.SLDPRT

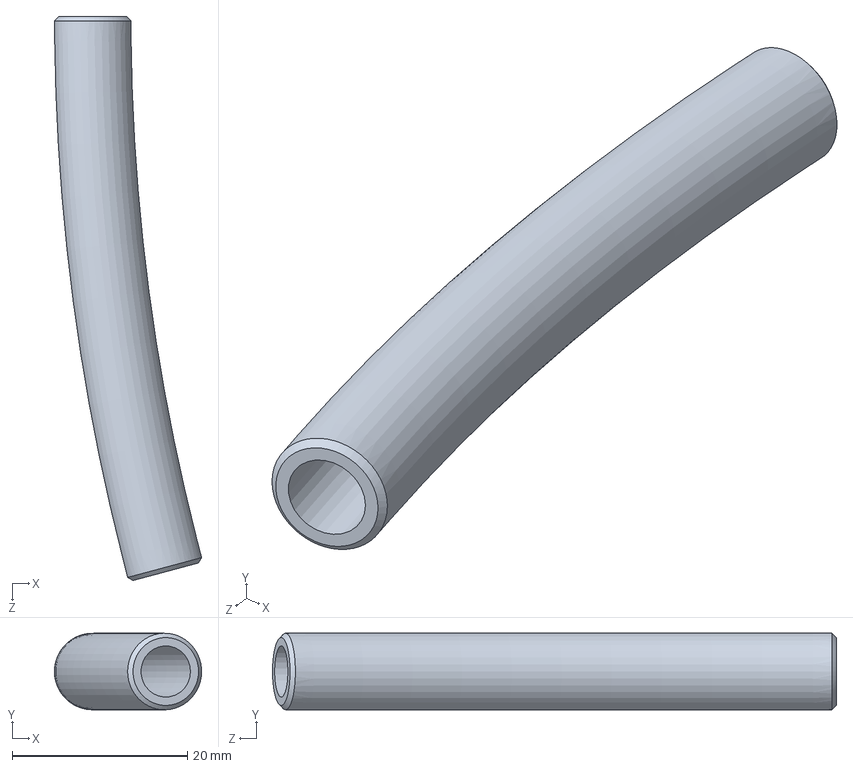
[picture p70: CAD file, 2017-01-10]
TS1_GR2/SW/nouvelleVersion/Pièce attache drone cercle/5mm.SLDPRT
16.8 x 8.74 x 64.4 mm
