creeperdeking/Tropodrone/TS1_GR2/SW/nouvelleVersion/Pièce triangle liaison ballon cercles/pièceTriangle.SLDPRT

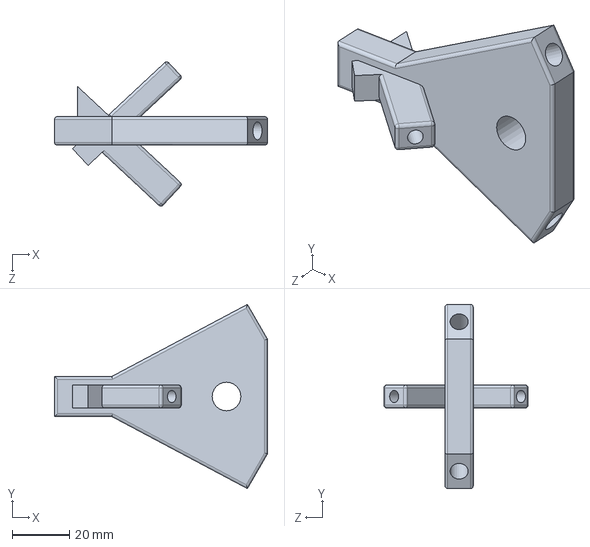
[picture p71: CAD file, 2017-04-11]
TS1_GR2/SW/nouvelleVersion/Pièce triangle liaison ballon cercles/pièceTriangle.SLDPRT
74.3 x 64.2 x 50.3 mm
