creeperdeking/Tropodrone/TS1_GR2/SW/ancienneVersion/Pièce attache drone cercle/Pièce1.SLDPRT

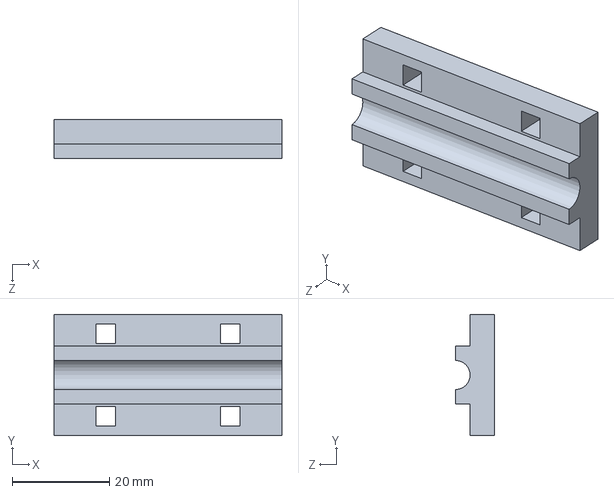
[picture p72: CAD file, 2017-01-10]
TS1_GR2/SW/ancienneVersion/Pièce attache drone cercle/Pièce1.SLDPRT
47.0 x 25.0 x 8.00 mm
