creeperdeking/Tropodrone/TS1_GR2/SW/ancienneVersion/Pièce triangle liaison ballon cercles/axesBallon.SLDPRT

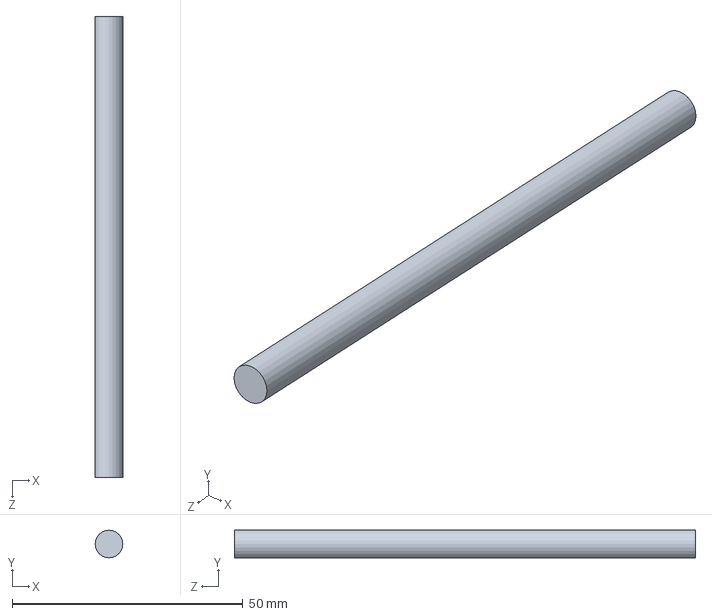
[picture p73: CAD file, 2017-01-10]
TS1_GR2/SW/ancienneVersion/Pièce triangle liaison ballon cercles/axesBallon.SLDPRT
6.00 x 6.00 x 100.0 mm
