creeperdeking/Tropodrone/TS1_GR2/SW/nouvelleVersion/BALLON.SLDPRT

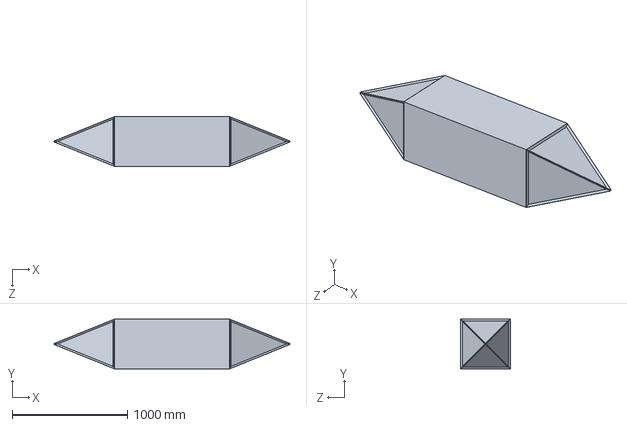
[picture p74: CAD file, 2017-04-11]
TS1_GR2/SW/nouvelleVersion/BALLON.SLDPRT
2044.4 x 430.0 x 430.0 mm
