creeperdeking/Tropodrone/TS1_GR2/SW/nouvelleVersion/Pièce attache drone cercle/4mm.SLDPRT

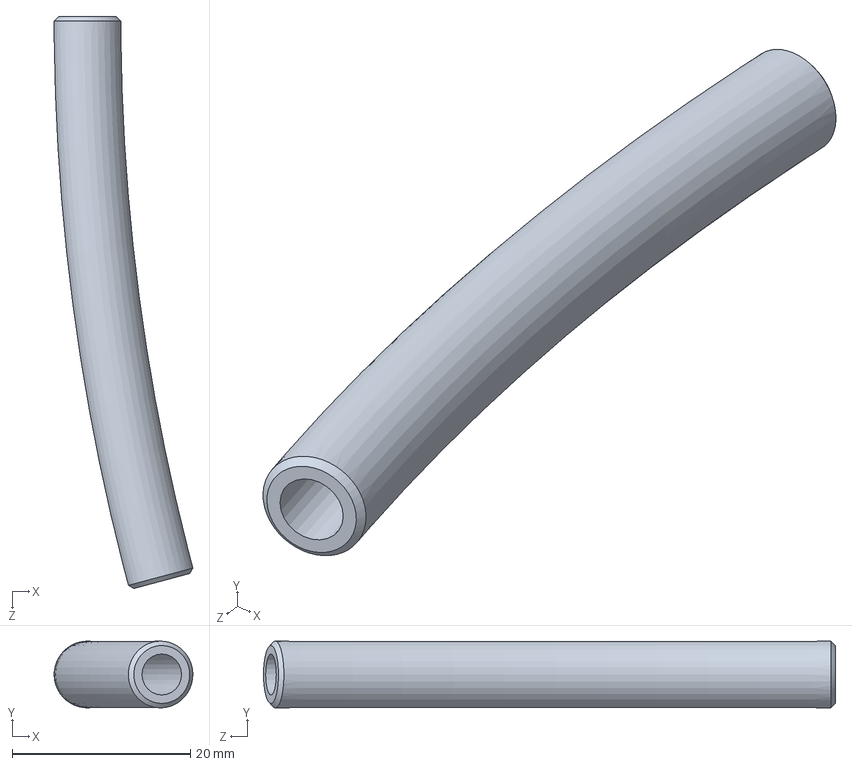
[picture p75: CAD file, 2017-01-10]
TS1_GR2/SW/nouvelleVersion/Pièce attache drone cercle/4mm.SLDPRT
15.6 x 7.50 x 64.3 mm
