creeperdeking/Tropodrone/TS1_GR2/SW/ancienneVersion/Ballon.SLDPRT

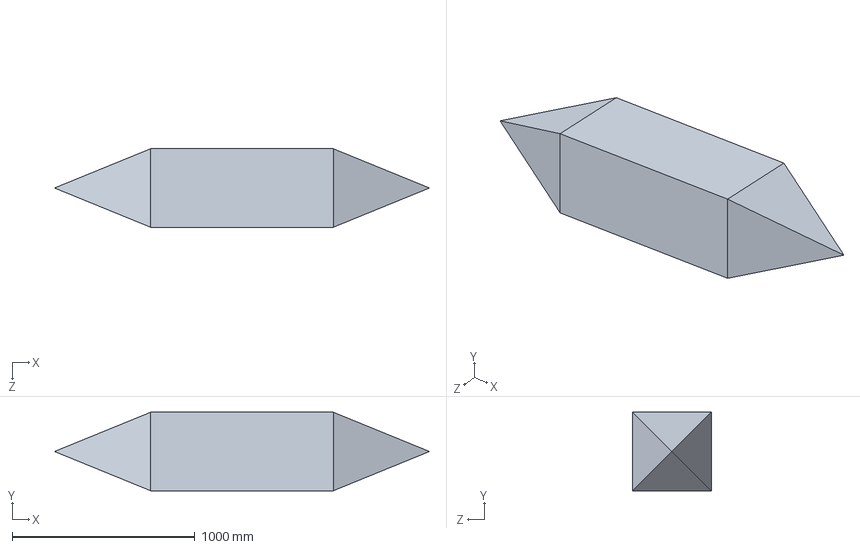
[picture p76: CAD file, 2017-04-11]
TS1_GR2/SW/ancienneVersion/Ballon.SLDPRT
2053.6 x 430.1 x 430.1 mm
