creeperdeking/Tropodrone/TS1_GR2/SW/nouvelleVersion/tigeCarboneCreux4mm.SLDPRT

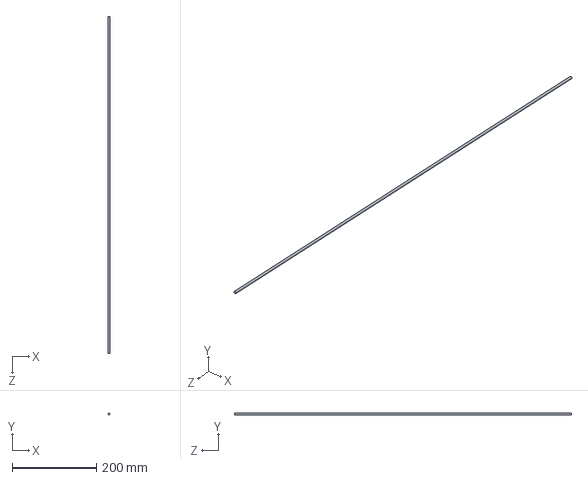
[picture p77: CAD file, 2017-04-11]
TS1_GR2/SW/nouvelleVersion/tigeCarboneCreux4mm.SLDPRT
4.00 x 4.00 x 800.0 mm
