creeperdeking/Tropodrone/TS1_GR2/SW/nouvelleVersion/tigeCarboneCreux6mm.SLDPRT

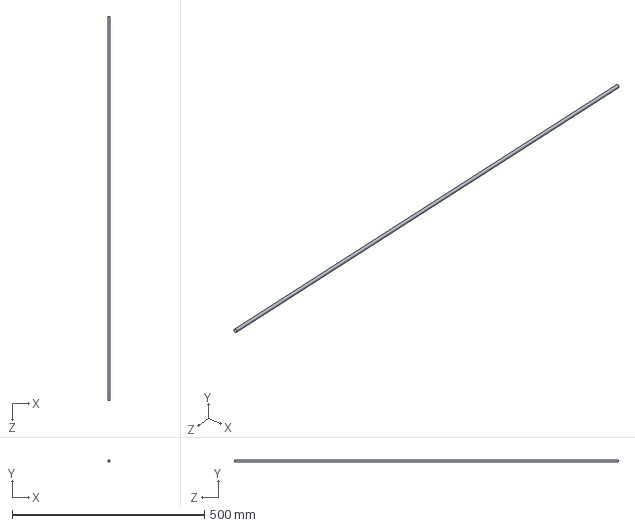
[picture p78: CAD file, 2017-04-11]
TS1_GR2/SW/nouvelleVersion/tigeCarboneCreux6mm.SLDPRT
6.00 x 6.00 x 1000.0 mm
