creeperdeking/Tropodrone/TS1_GR2/SW/ancienneVersion/supportTEMP.SLDPRT

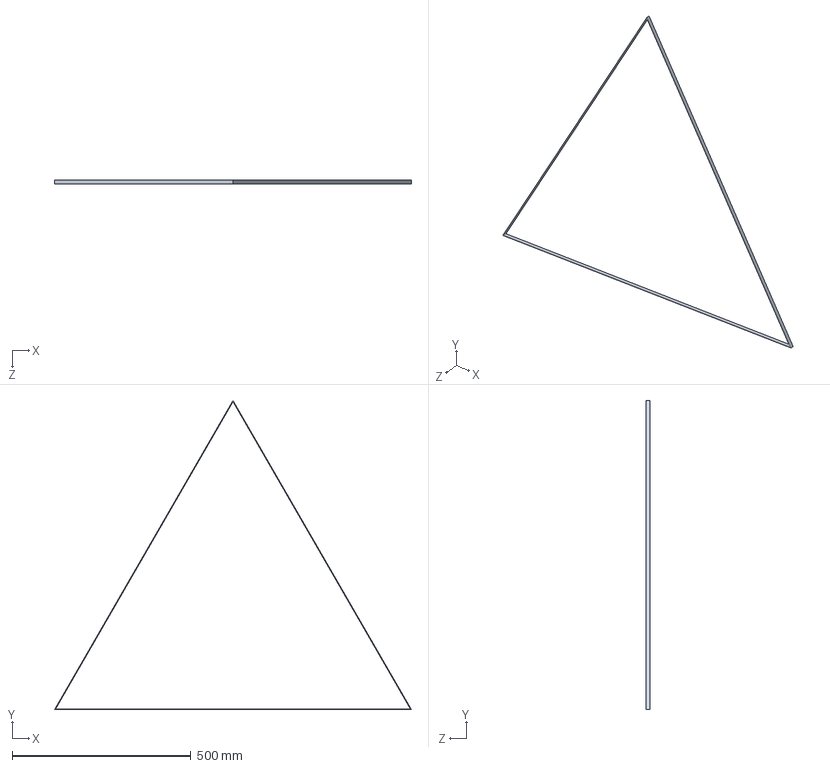
[picture p79: CAD file, 2017-04-11]
TS1_GR2/SW/ancienneVersion/supportTEMP.SLDPRT
1000.0 x 866.0 x 10.0 mm
