creeperdeking/Tropodrone/TS1_GR2/SW/nouvelleVersion/Corde.SLDPRT

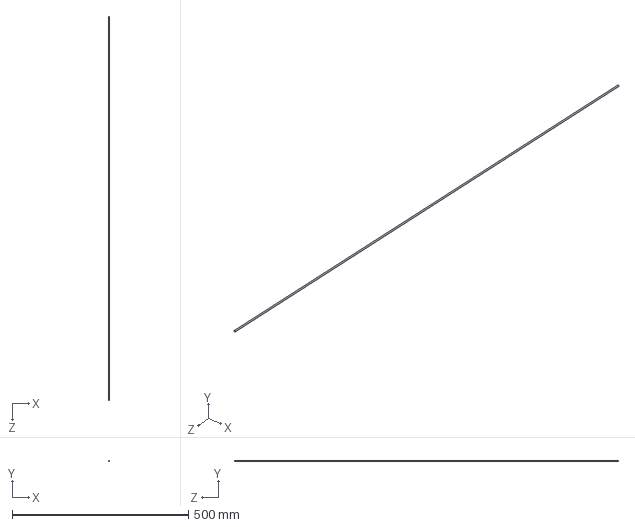
[picture p80: CAD file, 2017-04-11]
TS1_GR2/SW/nouvelleVersion/Corde.SLDPRT
3.00 x 3.00 x 1088.1 mm
