creeperdeking/Tropodrone/TS1_GR2/SW/nouvelleVersion/Drone.SLDPRT

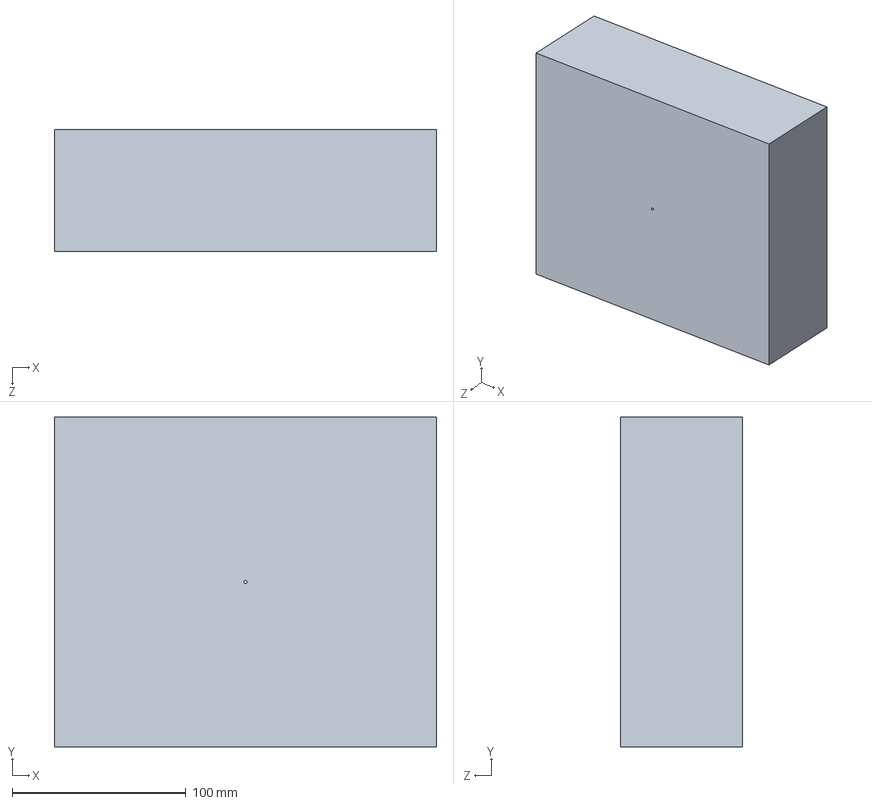
[picture p81: CAD file, 2017-04-11]
TS1_GR2/SW/nouvelleVersion/Drone.SLDPRT
220.0 x 190.0 x 70.0 mm
