creeperdeking/Tropodrone/TS1_GR2/SW/ancienneVersion/supportTEMP2.SLDPRT

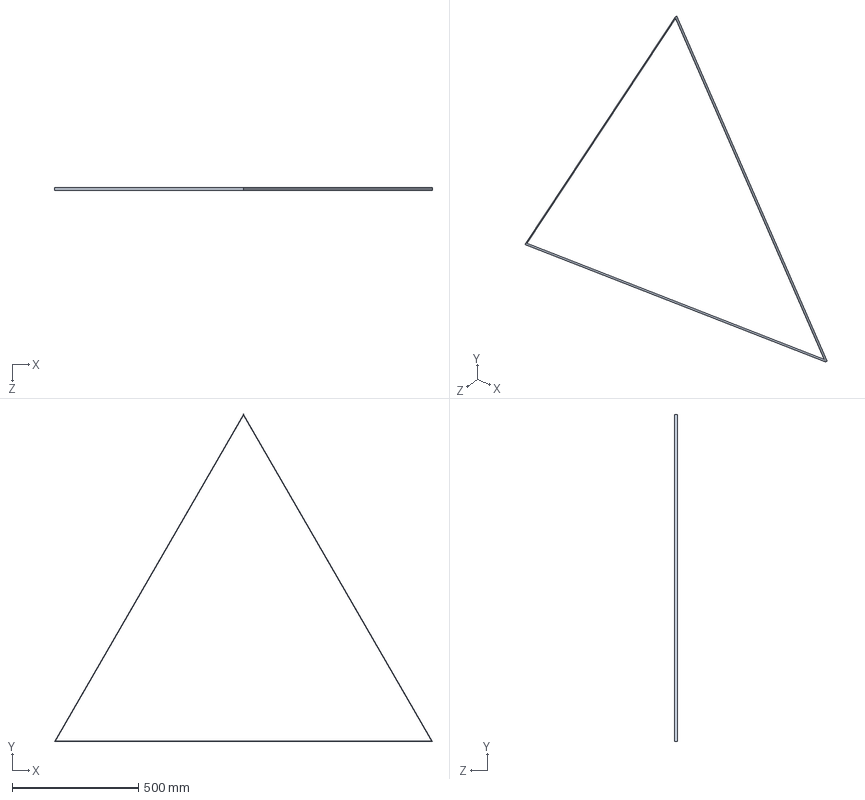
[picture p82: CAD file, 2017-04-11]
TS1_GR2/SW/ancienneVersion/supportTEMP2.SLDPRT
1500.0 x 1299.0 x 10.0 mm
