creeperdeking/Tropodrone/TS1_GR2/SW/nouvelleVersion/Bout.SLDPRT

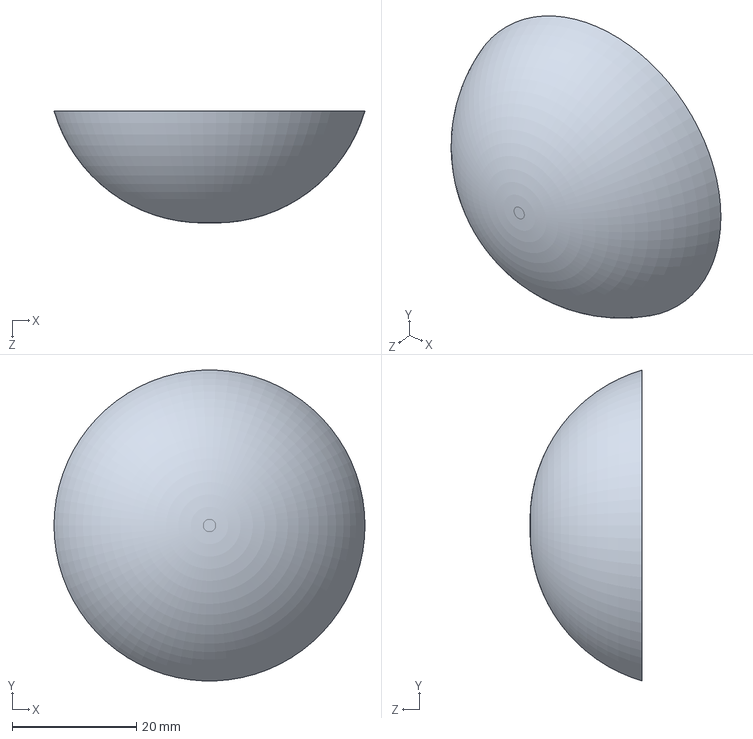
[picture p83: CAD file, 2017-04-11]
TS1_GR2/SW/nouvelleVersion/Bout.SLDPRT
50.0 x 50.0 x 18.0 mm
