creeperdeking/Tropodrone/TS1_GR2/SW/ancienneVersion/MaquetteTropodrone.STL

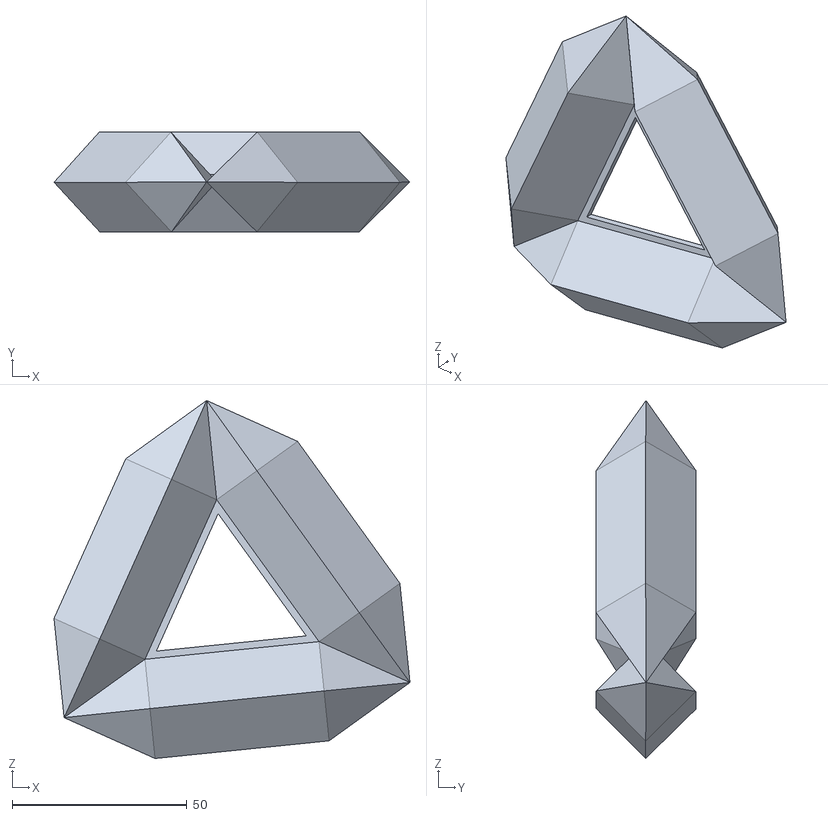
[picture p84: CAD file, 2017-04-11]
TS1_GR2/SW/ancienneVersion/MaquetteTropodrone.STL
101.7 x 28.5 x 102.3
