creeperdeking/Tropodrone/TS1_GR2/SW/ancienneVersion/Drone.SLDPRT

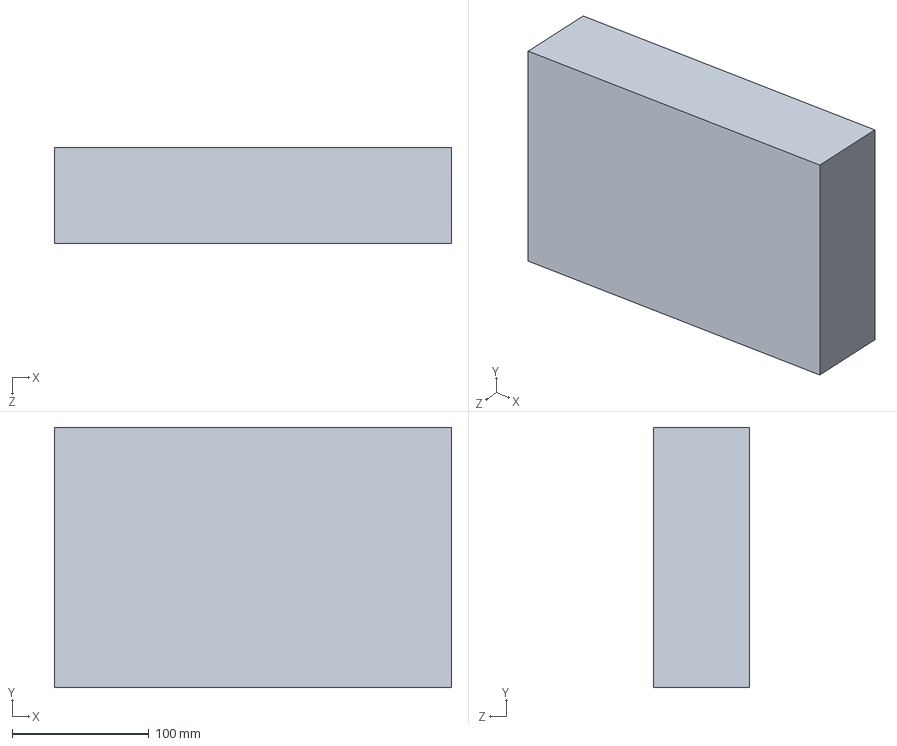
[picture p85: CAD file, 2017-04-11]
TS1_GR2/SW/ancienneVersion/Drone.SLDPRT
290.0 x 190.0 x 70.0 mm
