creeperdeking/Tropodrone/(list of files, cad)

Other CAD files:
TS1_GR2/SW/ancienneVersion/Ballon_2.sldprt
TS1_GR2/SW/ancienneVersion/supportTEMP_1.sldprt
TS1_GR2/SW/ancienneVersion/Drone_1.sldprt
TS1_GR2/SW/ancienneVersion/Ballon_1.sldprt
TS1_GR2/SW/ancienneVersion/tigeCarboneCreux6mm.SLDPRT
Pièces3D/Blend/ballon.blend
Pièces3D/Blend/cloche.blend
Pièces3D/Blend/collage.blend
Pièces3D/Blend/gyroscope.blend
Pièces3D/Blend/tropodrone.blend
TS1_GR2/SW/ancienneVersion/Assemblage1.IGS
TS1_GR2/SW/ancienneVersion/Assemblage1.STL
TS1_GR2/SW/ancienneVersion/Pièce attache drone cercle/3mm.STL
TS1_GR2/SW/ancienneVersion/Pièce attache drone cercle/4mm.STL
TS1_GR2/SW/ancienneVersion/Pièce attache drone cercle/5mm.STL
TS1_GR2/SW/ancienneVersion/supportTEMP_2.sldprt
TS1_GR2/SW/nouvelleVersion/Pièce attache drone cercle/3mm.STL
TS1_GR2/SW/nouvelleVersion/Pièce attache drone cercle/4mm.STL
TS1_GR2/SW/nouvelleVersion/Pièce attache drone cercle/5mm.STL
