creeperdeking/Tropodrone/(commit log)

2017-01-10 Pièces 3D et algo de calcul de portance et traînée
    [3mm.SLDPRT, 3mm.STL, 4mm.SLDPRT, 4mm.STL, 5mm.SLDPRT, 5mm.STL, Assemblage2.SLDASM, Pièce_PASD'ECART.SLDPRT]
2017-01-14 Ajout de Blend/, Scripts/, Ressource/, Latex/ et SVG/.
    [ballon.blend, tropodrone.blend]
2017-01-14 Ajout des sources du diapo et de l'entête Latex.
2017-01-14 Ajout d'une image vectorielle d'un des ballons du tropodrone.
2017-01-14 Ajout de .tex~ dans le .gitignore.
2017-01-14 Ecriture des sections et sous sections.
2017-01-14 Modification algo pour calculer resistance air : Cx est calculé automatiquement
2017-01-14 Completion des diapos : Enveloppe et Collage.
2017-01-14 Remplissage de toute la partie aérodynamisme et ajout d'une catégorie "courte présentation" au début du diapo
2017-01-14 Ajout des diapos sur la dilatation des gaz.
2017-01-15 Ajout des diapos sur la forme des ballons.
2017-01-15 Ajout de \displaystyle{}.
2017-01-15 Thibaut: \times au lieu de *.
2017-01-15 Correction d'une phrase vide de sens
2017-01-15 Ajout de la diapo sur la poussé d'archimède.
2017-01-15 Ajout de la seconde diapo sur la poussé d'archimède.
2017-01-15 Ajout de la diapo sur le dron.
2017-01-15 Correction sur les colles et enveloppes.
2017-01-15 Utilisation de \boxed{}.
2017-01-16 Ajout de la signification des formules
2017-01-16 Ajout de photos + correction.
2017-01-16 Correction des formules de volume.
2017-01-17 Mise sous forme de liste catégorie aérodynamisme
2017-01-17 Ajout d'une diapo sur les taches à faire.
2017-01-17 Descritpion des formules en listes.
2017-01-17 Déplacemement de la partie sur l'élévation.
2017-01-17 Titres aux diapos de présentation
2017-03-20 Refonte du diapo pour la econde revue de projet.
    [ballon.blend, collage.blend, gyroscope.blend, plan_ballon.SLDDRW, plan_ballon.SLDPRT]
2017-04-04 Commit d'il y a 2 mois...
    [temp.blend]
2017-04-11 Réorganisation du dossier et ajout des fichiers du framapad
    [3mm.SLDPRT, 3mm.STL, 4mm.SLDPRT, 4mm.STL, 5mm.SLDPRT, 5mm.STL, Assemblage1 - Ballon-1.STL, Assemblage1 - Ballon-2.STL]
2017-04-24 Ajout dans le dossier de la partie sur la poussé d'Archimède.
2017-04-24 Ajout de la partie sur la dilatation des gazs.
2017-04-27 Partie sur l'aérodynamisme (en cours de rédaction)
2017-05-01 Ajout de la partie sur la forme des ballons.
2017-05-02 Correction de la compilation.
    Ce n'est pas parce que le pdf semble être généré que les erreurs ne sont pas présentes.
2017-05-10 Ajout de la partie sur les colles.
2017-05-10 Correction de fautes.
2017-05-11 Ajout d'une partie sur l'étanchéité.
    [cloche.blend]
2017-05-11 Ajout de texte pour la structure
2017-05-11 Correction et ajout de légendes.
2017-05-11 Amélioration de la partie aérodynamisme
2017-05-11 Ajout dans la partie colles et materiaux.
2017-05-11 Ajout de la partie sur le remplissage.
2017-05-11 Ajout de ref et correction forme.
2017-05-11 Enlever les musiques
2017-05-16 Ajout de sources.
